AGH-Drone-Engineering/RPi_CM_Drone_Board/images/render2.png

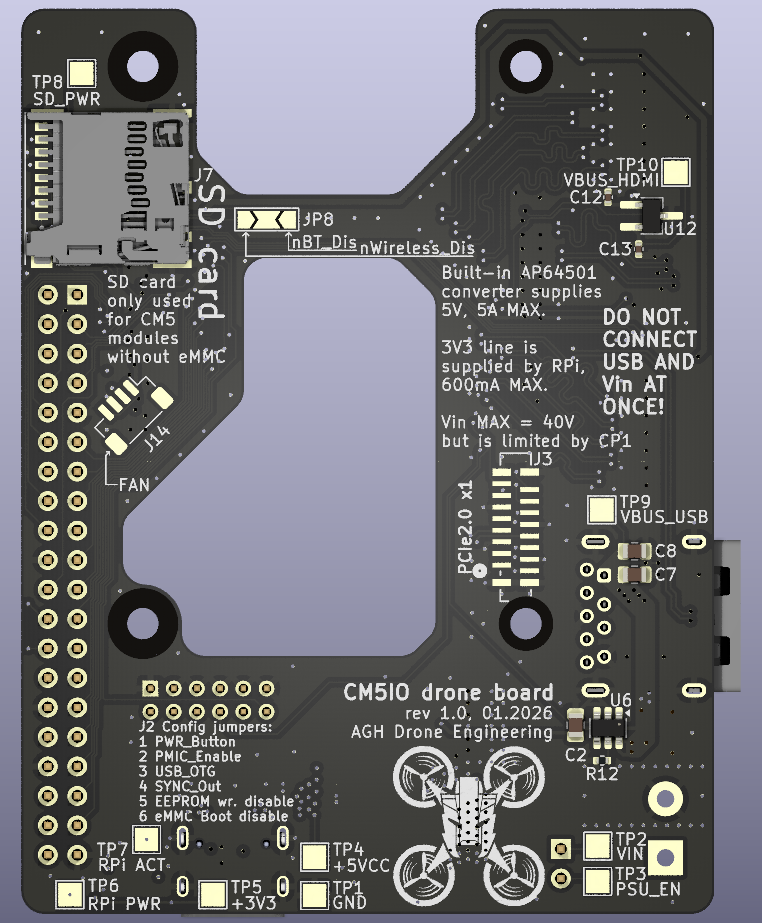
images/render2.png
