AGH-Drone-Engineering/RPi_CM_Drone_Board/images/render4.png

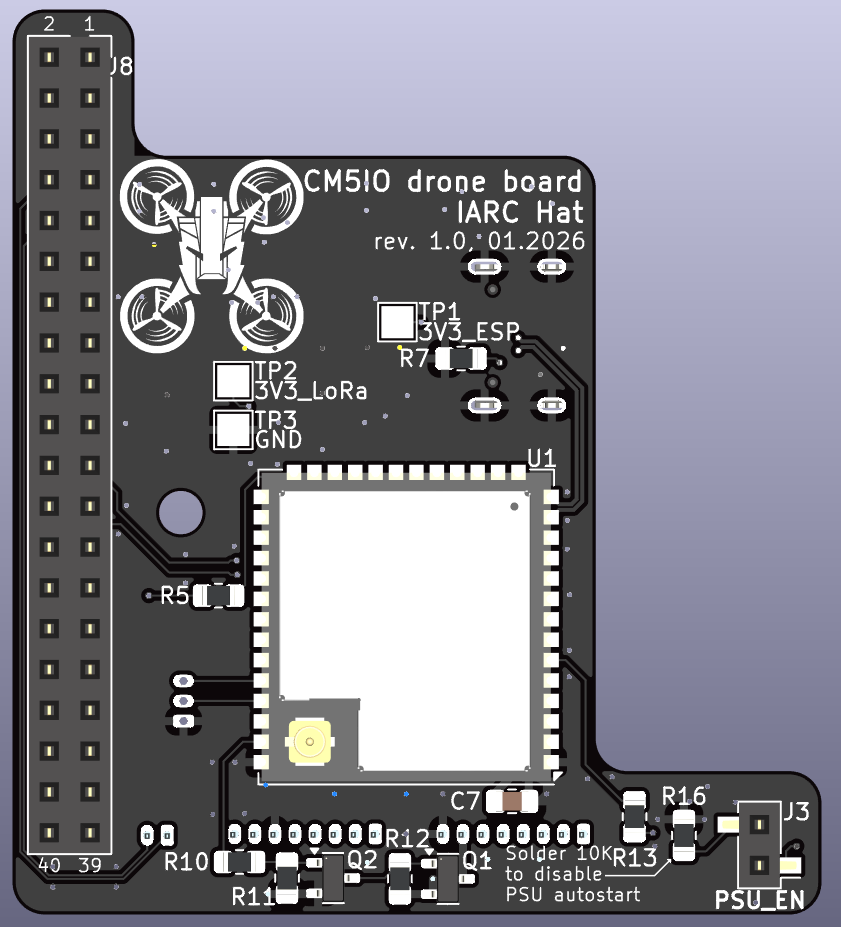
images/render4.png
