AGH-Drone-Engineering/RPi_CM_Drone_Board/images/board1.png

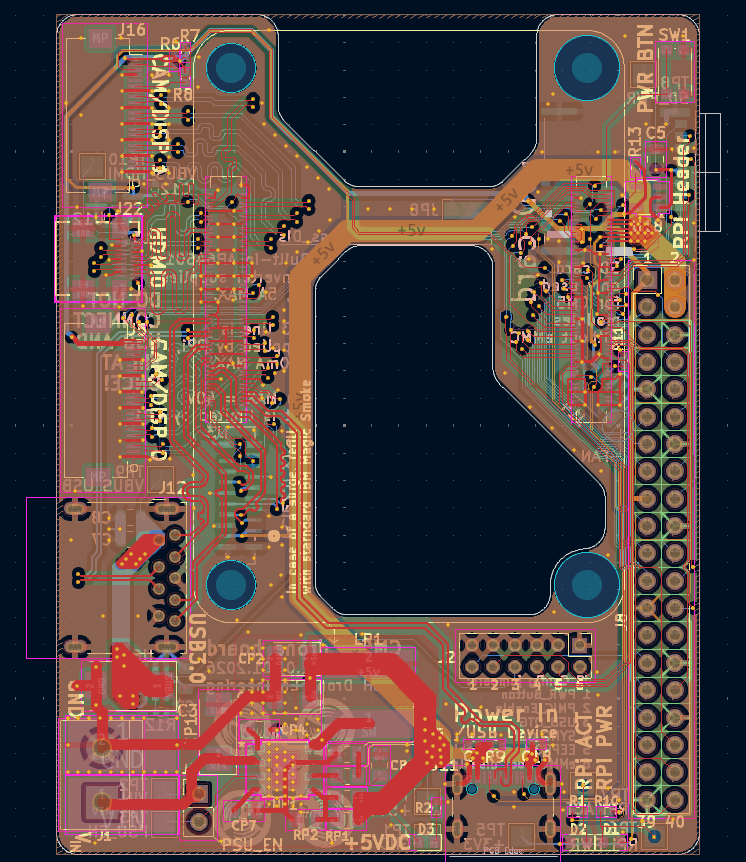
images/board1.png
