AGH-Drone-Engineering/RPi_CM_Drone_Board/images/board2.png

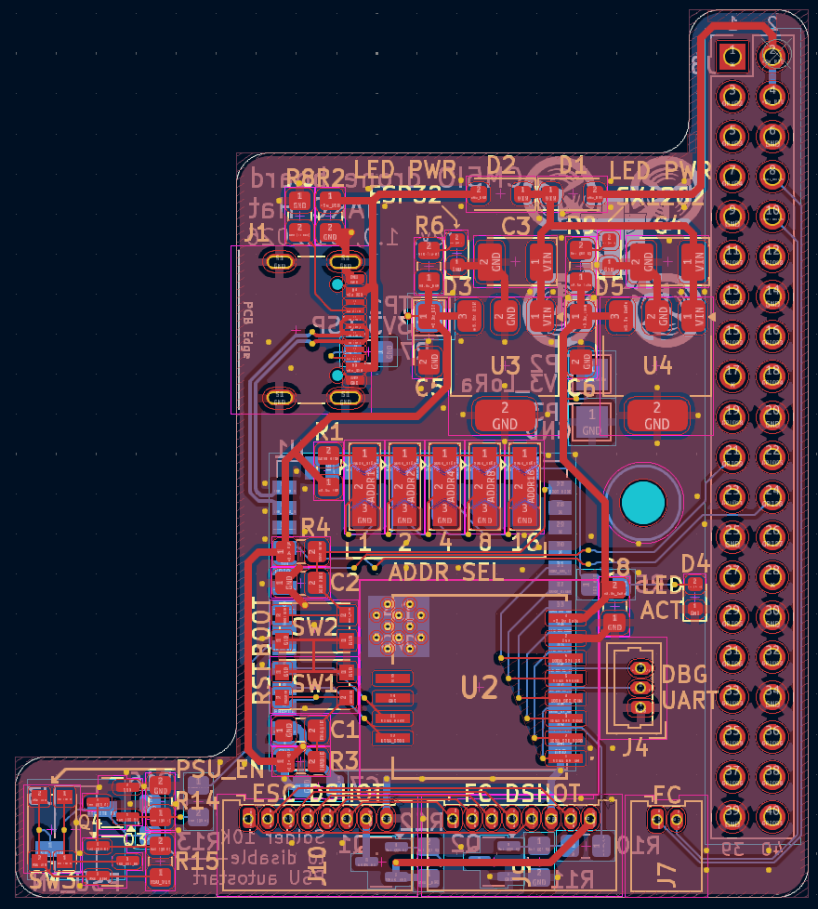
images/board2.png
