AGH-Drone-Engineering/RPi_CM_Drone_Board/images/render1.png

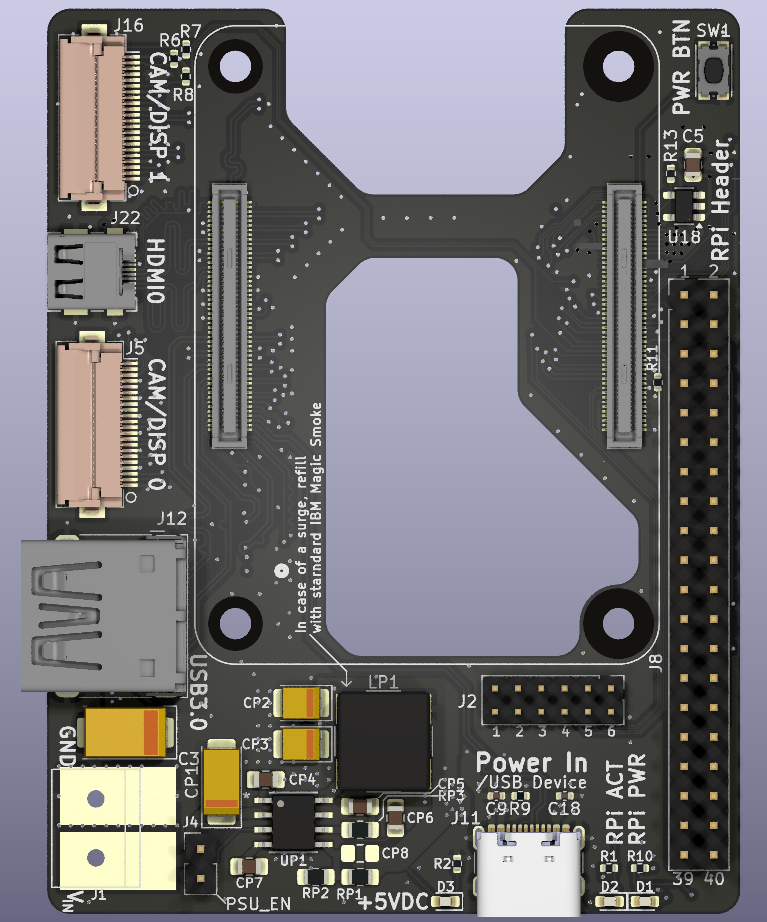
images/render1.png
