AGH-Drone-Engineering/RPi_CM_Drone_Board/images/render3.png

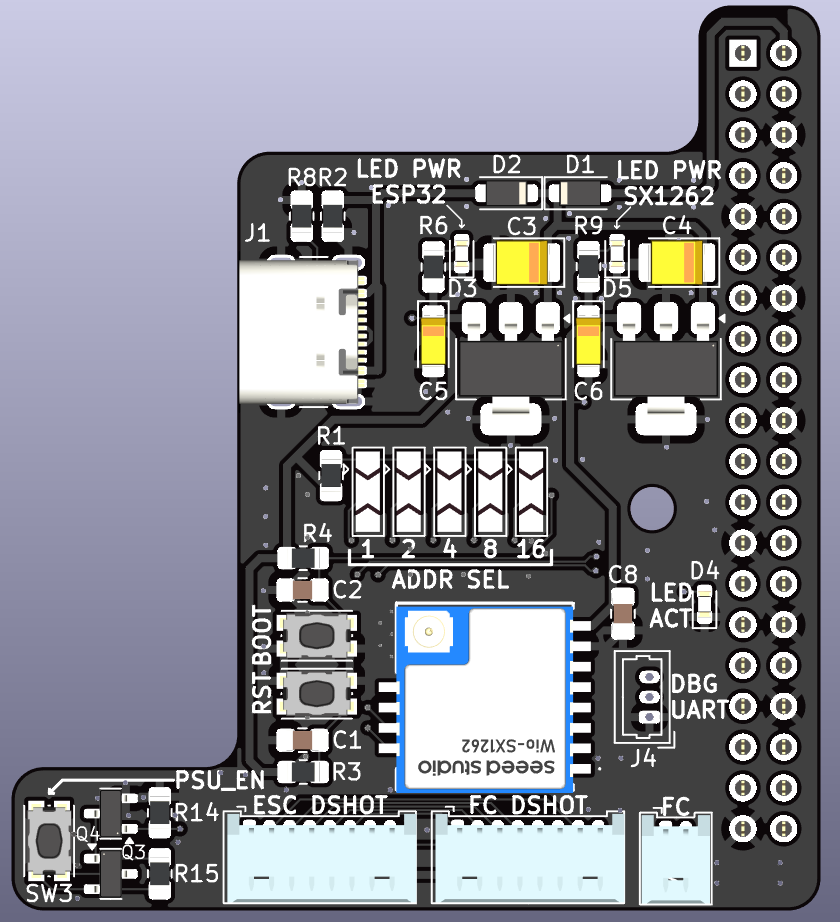
images/render3.png
