AGH-Drone-Engineering/RPi_CM_Drone_Board/pcb_CMDB_rev1/RPI-CM5IO-R2-Gerber050325/Required_impedance_control.xlsx

Signal Layer | Reference Layer | Impedance Type | Trace Width（mil) | Trace Spacing（mil) | Impedance(ohm)±10% | Position
L1 | L2 | Differential Pair (Non coplanar) | 4.25 | 5.9055 | 100
L4 | L3 | Differential Pair (Non coplanar) | 4.25 | 5.9055 | 100
L1 | L2 | Differential Pair (Non coplanar) | 6.6 | 9.9606 | 90
L4 | L3 | Differential Pair (Non coplanar) | 6.6 | 9.9606 | 90
