AGH-Drone-Engineering/RPi_CM_Drone_Board/pcb_CMDB_Adv/CMDB_Adv.kicad_pcb

## KiCad design pcb_CMDB_Adv/CMDB_Adv.kicad_pcb (2026-09-06)

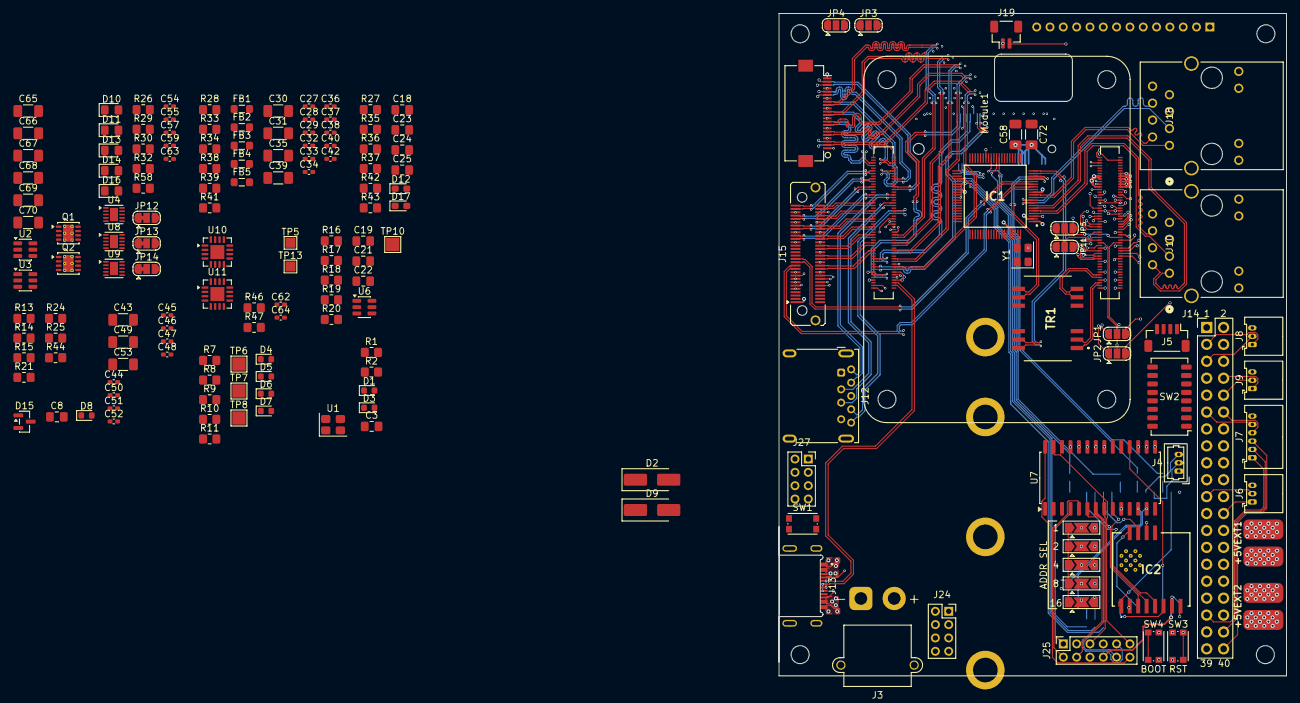
[picture p7: board CMDB_Adv.kicad_pcb from above]

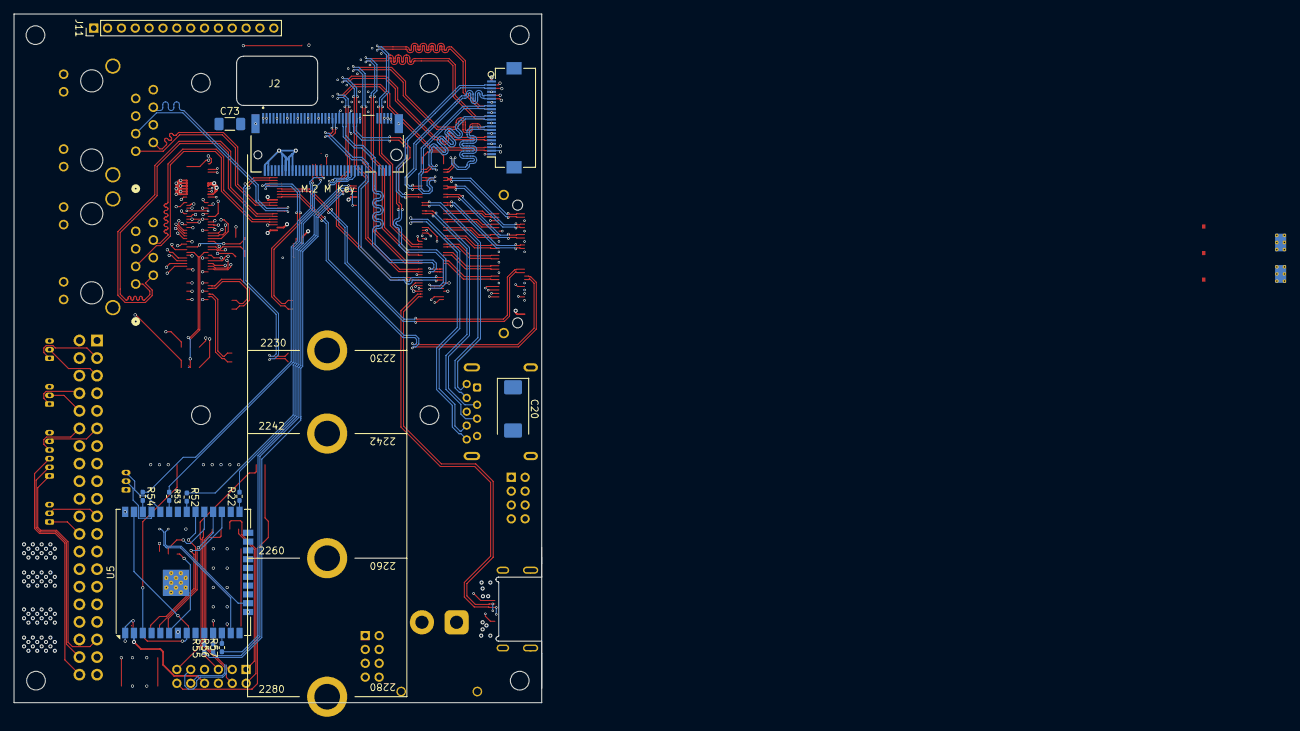
[picture p8: board CMDB_Adv.kicad_pcb from below]

Board: 6 copper layers, 76.2 x 99.4 mm, 190 parts (13 on the bottom side), 277 nets.

Parts:
C3, C18, C23, C24, C25: 100n; C_0805_2012Metric_Pad1.18x1.45mm_HandSolder
C8: 470nF; C_0805_2012Metric_Pad1.18x1.45mm_HandSolder
C19, C21, C22: 10u; C_0805_2012Metric_Pad1.18x1.45mm_HandSolder
C20: 100uF; CP_EIA-7343-31_Kemet-D
C27, C28, C29, C32, C33, C34, C36, C37, C38, C40, C42, C44, C45, C46, C47, C48, C50, C51, C52, C54, C55, C57, C59, C62, C63, C64: 100nF; C_0402_1005Metric_Pad0.74x0.62mm_HandSolder
C30, C31, C35, C39, C43, C49, C58, C72, C73: 22uF; C_1206_3216Metric_Pad1.33x1.80mm_HandSolder
C53, C65, C66, C67, C68, C69, C70: 10uF; C_1206_3216Metric_Pad1.33x1.80mm_HandSolder
D1, D8: LED Green; LED_0603_1608Metric
D2, D9: SS34; D_SMA_Handsoldering
D3: LED Red; LED_0603_1608Metric
D4, D6: GREEN; LED_0603_1608Metric
D5: RED; LED_0603_1608Metric
D7: AMBER; LED_0603_1608Metric
D10: PWR_VALID; D_0805_2012Metric_Pad1.15x1.40mm_HandSolder
D11: +5VPB; D_0805_2012Metric_Pad1.15x1.40mm_HandSolder
D12: ETH4_Y; LED_0603_1608Metric_Pad1.05x0.95mm_HandSolder
D13: +5VEXT1; D_0805_2012Metric_Pad1.15x1.40mm_HandSolder
D14: +5VEXT2; D_0805_2012Metric_Pad1.15x1.40mm_HandSolder
D15: BAT54A; SOT-23
D16: +VIMM; D_0805_2012Metric_Pad1.15x1.40mm_HandSolder
D17: ETH4_G; LED_0603_1608Metric_Pad1.05x0.95mm_HandSolder
FB1, FB2, FB3, FB4, FB5: BLM21PG221SN1D; L_0805_2012Metric_Pad1.05x1.20mm_HandSolder
H1, H2, H3, H4: MountingHole; MountingHole_2.7mm_M2.5_DIN965
IC1: KSZ8795CLXCC; QFP40P1200X1200X160-80N
IC2: Wio-SX1262
J2: Bus_M.2_Socket_M; M.2_M_Key_socket_2280
J3: CONN_VIN; AMASS_XT30PW-M_1x02_P2.50mm_Horizontal
J4: J_ESP_DBG_UART; Molex_PicoBlade_53047-0310_1x03_P1.25mm_Vertical
J5: CONN_FAN; JST_SH_BM04B-SRSS-TB_1x04-1MP_P1.00mm_Vertical
J6: CONN_UART2; Molex_PicoBlade_53048-0310_1x03_P1.25mm_Horizontal
J7: CONN_SPI1; Molex_PicoBlade_53048-0610_1x06_P1.25mm_Horizontal
J8: CONN_I2C1; Molex_PicoBlade_53048-0310_1x03_P1.25mm_Horizontal
J9: CONN_UART0; Molex_PicoBlade_53048-0310_1x03_P1.25mm_Horizontal
J10: ETH1; CONN12_ARJM11B1-009-AB-EW2_ABR
J11: CONN_SDIO; PinHeader_1x14_P2.00mm_Vertical
J12: CONN_USB3_A; USB3_A_Molex_48393-001
J13: CONN_USB_PWR_OTG; GCT_USB4510-03-1-A_REVA
J14: CONN_HAT; PinHeader_2x20_P2.54mm_Vertical
J15: CONN_DOCK; Samtec_LSHM-130-xx.x-x-DV-S_2x30-1SH_P0.50mm_Vertical
J16: CONN_CAM1; Hirose_FH12-22S-0.5SH_1x22-1MP_P0.50mm_Horizontal
J17: CONN_CAM0; Hirose_FH12-22S-0.5SH_1x22-1MP_P0.50mm_Horizontal
J18: ETH2; CONN12_ARJM11B1-009-AB-EW2_ABR
J19: CONN_RTC; JST_SH_BM02B-SRSS-TB_1x02-1MP_P1.00mm_Vertical
J20: CONN_5VEXT1; SolderWirePad_1x01_SMD_3x6mm
J21: CONN_5VEXT1_GND; SolderWirePad_1x01_SMD_3x6mm
J22: CONN_5VEXT2; SolderWirePad_1x01_SMD_3x6mm
J23: CONN_5VEXT2_GND; SolderWirePad_1x01_SMD_3x6mm
J24: AUX_PWR_OUT1; PinSocket_2x04_P2.00mm_Vertical
J25: PL_CTRL_IO; PinSocket_2x06_P2.00mm_Vertical
J27: AUX_PWR_OUT2; PinSocket_2x04_P2.00mm_Vertical
JP1: GPIO0_SEL; SolderJumper-3_P1.3mm_Open_RoundedPad1.0x1.5mm
JP2: GPIO1_SEL; SolderJumper-3_P1.3mm_Open_RoundedPad1.0x1.5mm
JP3: ETH_Y_SEL; SolderJumper-3_P1.3mm_Open_RoundedPad1.0x1.5mm
JP4: ETH_G_SEL; SolderJumper-3_P1.3mm_Open_RoundedPad1.0x1.5mm
JP5: GPIO8_SEL; SolderJumper-3_P1.3mm_Open_RoundedPad1.0x1.5mm
JP6: ADDR1; SolderJumper-3_P2.0mm_Open_TrianglePad1.0x1.5mm
JP7: ADDR2; SolderJumper-3_P2.0mm_Open_TrianglePad1.0x1.5mm
JP8: ADDR4; SolderJumper-3_P2.0mm_Open_TrianglePad1.0x1.5mm
JP9: ADDR8; SolderJumper-3_P2.0mm_Open_TrianglePad1.0x1.5mm
JP10: ADDR16; SolderJumper-3_P2.0mm_Open_TrianglePad1.0x1.5mm
JP11: GPIO9_SEL; SolderJumper-3_P1.3mm_Open_RoundedPad1.0x1.5mm
JP12: +3V3PB2 DIS; SolderJumper-3_P1.3mm_Bridged12_RoundedPad1.0x1.5mm
JP13: +3V3PB3 DIS; SolderJumper-3_P1.3mm_Bridged12_RoundedPad1.0x1.5mm
JP14: +1V2PB DIS; SolderJumper-3_P1.3mm_Bridged12_RoundedPad1.0x1.5mm
Module1: ComputeModule5-CM5; Raspberry-Pi-5-Compute-Module
Q1, Q2: AON7534; DFN-8-1EP_3x3mm_P0.65mm_EP1.6x2.56mm_ThermalVias
R1, R2, R7, R8, R9, R10, R13, R21, R26, R29, R30, R32, R34, R39, R41, R42, R43, R46, R47, R58: 1K; R_0805_2012Metric_Pad1.20x1.40mm_HandSolder
R11, R44: 10K; R_0805_2012Metric_Pad1.20x1.40mm_HandSolder
R14, R15, R38: 4K7; R_0805_2012Metric_Pad1.20x1.40mm_HandSolder
R16, R18, R19, R20: 2.2K; R_0805_2012Metric_Pad1.20x1.40mm_HandSolder
R17: 15K; R_0805_2012Metric_Pad1.20x1.40mm_HandSolder
R22, R52, R53, R54, R55, R56, R57: 22R; R_0402_1005Metric_Pad0.72x0.64mm_HandSolder
R24, R25: 2K2; R_0805_2012Metric_Pad1.20x1.40mm_HandSolder
R27, R35, R36, R37: 220R; R_0805_2012Metric_Pad1.20x1.40mm_HandSolder
R28: 12K4 1%; R_0805_2012Metric_Pad1.20x1.40mm_HandSolder
R33: 330R; R_0805_2012Metric_Pad1.20x1.40mm_HandSolder
SW1: BT_PWR; SW_Push_1P1T_NO_CK_KMR2
SW2: SW_CONFIG; SW_DIP_SPSTx08_Slide_Copal_CHS-08A_W5.08mm_P1.27mm_JPin
SW3: SW_RESET; SW_Push_1P1T_NO_CK_KMR2
SW4: SW_BOOT; SW_Push_1P1T_NO_CK_KMR2
TP5: PWR_VALID0; TestPoint_Pad_1.5x1.5mm
TP6: +3V3 RPi; TestPoint_Pad_2.0x2.0mm
TP7: TP nPWR; TestPoint_Pad_2.0x2.0mm
TP8: TP nACT; TestPoint_Pad_2.0x2.0mm
TP10: TP VBUS_USB; TestPoint_Pad_2.0x2.0mm
TP13: PWR_VALID1; TestPoint_Pad_1.5x1.5mm
TR1: ALANL100X1-DE12DT; ALANL100X1DE12DT
U1: ASEK-32.768KHZ-L-R-T; Crystal_SMD_3225-4Pin_3.2x2.5mm
U2, U3: LM74700; SOT-23-6
U4, U8, U9: TPS7A91; Texas_S-PDSO-N10_EP1.2x2mm
U5: ESP32-WROOM-32UE
U6: AP22653W6; SOT-23-6
U7: MCP23017_SO; SOIC-28W_7.5x17.9mm_P1.27mm
U10, U11: INA3221; Texas_RGV0016A_VQFN-16-1EP_4x4mm_P0.65mm_EP2.1x2.1mm
Y1: ASE-25.000MHZ-LC-T; Oscillator_SMD_Abracon_ASE-4Pin_3.2x2.5mm

Connections:
/+1V2PB: C66.1, FB3.1, FB4.1, U9.1 (OUT), U9.2 (OUT)
/+3V3PB1: C3.1, C58.2, C72.2, C73.2, D1.2 (A), D3.2 (A), J2.2 (3.3V), J2.4 (3.3V), J2.12 (3.3V), J2.14 (3.3V), J2.16 (3.3V), J2.18 (3.3V), J2.70 (3.3V), J2.72 (3.3V), J2.74 (3.3V), U1.1 (EN), U1.4 (VDD)
/+3V3PB2: C49.2, C50.2, C51.2, C52.2, C67.1, D15.1, FB1.1, FB2.1, J25.8, R13.1, R14.1, R15.1, R24.1, R25.1, R44.2, U4.1 (OUT), U4.2 (OUT), U5.2 (VDD), U7.9 (V_{DD})
/+3V3PB3: C43.2, C44.2, C68.1, IC2.8 (VCC), U8.1 (OUT), U8.2 (OUT)
/+5VEXT1: D13.2 (A), J20.1 (Pin_1_1)
/+5VEXT2: D14.2 (A), J22.1 (Pin_1_1)
/+5VPB: C19.1, D11.2 (A), J5.1, J14.2, J14.4, J15.1, Module1.77 (+5v_(Input)), Module1.79 (+5v_(Input)), Module1.81 (+5v_(Input)), Module1.83 (+5v_(Input)), Module1.85 (+5v_(Input)), Module1.87 (+5v_(Input)), Q1.1 (D), Q2.1 (D), U2.4 (CATHODE), U3.4 (CATHODE), U6.1 (IN)
/+VBUS_USBC: C55.2, D2.2 (A), J13.A4_B9 (VBUS), J13.B4_A9 (VBUS), Q2.3 (S), R16.1, U3.3 (EN), U3.6 (ANODE)
/CM5/+3V3RPi: D4.2 (A), D5.2 (A), D6.2 (A), D7.2 (A), J11.1, J14.1, J14.17, J15.3, J16.22, J17.22, Module1.78 (GPIO_VREF(1.8v/3.3v_Input)), Module1.84 (+3.3v_(Output)), Module1.86 (+3.3v_(Output)), R11.1, R18.2, R19.2, R20.1, R27.2, R35.2, R36.2, R37.2, R42.2, R43.2, TP6.1 (1_1)
/CM5/+3V3STB: J19.2, Module1.76 (VBAT)
/CM5/BT_nDis: Module1.91 (BT_nDisable), SW2.11
/CM5/CAM0_GPIO0: J17.17, Module1.97 (CAM_GPIO0)
/CM5/CAM0_GPIO1: J17.18, Module1.100 (CAM_GPIO1)
/CM5/EEPROM_nWP: Module1.20 (EEPROM_nWP), SW2.15
/CM5/ETH.P0_N: Module1.10 (Ethernet_Pair0_N), TR1.6 (RD-)
/CM5/ETH.P0_P: Module1.12 (Ethernet_Pair0_P), TR1.5 (RD+)
/CM5/ETH.P1_N: Module1.6 (Ethernet_Pair1_N), TR1.2 (TD-)
/CM5/ETH.P1_P: Module1.4 (Ethernet_Pair1_P), TR1.1 (TD+)
/CM5/ETH_LED_G: JP4.2 (C), R9.2
/CM5/ETH_LED_Y: JP3.2 (C), R10.2
/CM5/FAN_PWM: J5.2, Module1.19 (FAN_PWM), R11.2
/CM5/GP.0: J14.27, JP1.3 (B)
/CM5/GP.1: J14.28, JP2.3 (B)
/CM5/GP.2: J8.1, J14.3, Module1.58 (GPIO2)
/CM5/GP.3: J8.2, J14.5, Module1.56 (GPIO3)
/CM5/GP.4: J6.1, J14.7, Module1.54 (GPIO4)
/CM5/GP.5: J6.2, J14.29, Module1.34 (GPIO5)
/CM5/GP.6: J14.31, Module1.30 (GPIO6)
/CM5/GP.7: J14.26, Module1.37 (GPIO7)
/CM5/GP.8: J14.24, JP5.3 (B)
/CM5/GP.9: J14.21, JP11.3 (B)
/CM5/GP.10: J14.19, Module1.44 (GPIO10)
/CM5/GP.11: J14.23, Module1.38 (GPIO11)
/CM5/GP.12: J14.32, Module1.31 (GPIO12)
/CM5/GP.13: J14.33, Module1.28 (GPIO13)
/CM5/GP.14: J9.1, J14.8, Module1.55 (GPIO14)
/CM5/GP.15: J9.2, J14.10, Module1.51 (GPIO15)
/CM5/GP.16: J14.36, Module1.29 (GPIO16)
/CM5/GP.17: J7.5, J14.11, Module1.50 (GPIO17)
/CM5/GP.18: J7.4, J14.12, Module1.49 (GPIO18)
/CM5/GP.19: J7.1, J14.35, Module1.26 (GPIO19)
/CM5/GP.20: J7.2, J14.38, Module1.27 (GPIO20)
/CM5/GP.21: J7.3, J14.40, Module1.25 (GPIO21)
/CM5/GP.22: J14.15, Module1.46 (GPIO22)
/CM5/GP.23: J14.16, Module1.47 (GPIO23)
/CM5/GP.24: J14.18, Module1.45 (GPIO24)
/CM5/GP.25: J14.22, Module1.41 (GPIO25)
/CM5/GP.26: J14.37, Module1.24 (GPIO26)
/CM5/GP.27: J14.13, Module1.48 (GPIO27)
/CM5/GPIO0_RAW: JP1.2 (C), Module1.36 (ID_SD)
/CM5/GPIO1_RAW: JP2.2 (C), Module1.35 (ID_SC)
/CM5/GPIO8_RAW: JP5.2 (C), Module1.39 (GPIO8)
/CM5/GPIO9_RAW: JP11.2 (C), Module1.40 (GPIO9)
/CM5/HDMI0.CEC: J15.15, Module1.151 (HDMI0_CEC)
/CM5/HDMI0.CK_N: J15.59, Module1.190 (HDMI0_CLK_N)
/CM5/HDMI0.CK_P: J15.57, Module1.188 (HDMI0_CLK_P)
/CM5/HDMI0.D0_N: J15.53, Module1.184 (HDMI0_TX0_N)
/CM5/HDMI0.D0_P: J15.51, Module1.182 (HDMI0_TX0_P)
/CM5/HDMI0.D1_N: J15.47, Module1.178 (HDMI0_TX1_N)
/CM5/HDMI0.D1_P: J15.45, Module1.176 (HDMI0_TX1_P)
/CM5/HDMI0.D2_N: J15.41, Module1.172 (HDMI0_TX2_N)
/CM5/HDMI0.D2_P: J15.39, Module1.170 (HDMI0_TX2_P)
/CM5/HDMI0.HP: J15.17, Module1.153 (HDMI0_HOTPLUG)
/CM5/HDMI0.SCL: J15.11, Module1.200 (HDMI0_SCL)
/CM5/HDMI0.SDA: J15.13, Module1.199 (HDMI0_SDA)
/CM5/HDMI1.CEC: J15.16, Module1.149 (HDMI1_CEC)
/CM5/HDMI1.CK_N: J15.60, Module1.166 (HDMI1_CLK_N)
/CM5/HDMI1.CK_P: J15.58, Module1.164 (HDMI1_CLK_P)
/CM5/HDMI1.D0_N: J15.54, Module1.160 (HDMI1_TX0_N)
/CM5/HDMI1.D0_P: J15.52, Module1.158 (HDMI1_TX0_P)
/CM5/HDMI1.D1_N: J15.48, Module1.154 (HDMI1_TX1_N)
/CM5/HDMI1.D1_P: J15.46, Module1.152 (HDMI1_TX1_P)
/CM5/HDMI1.D2_N: J15.42, Module1.148 (HDMI1_TX2_N)
/CM5/HDMI1.D2_P: J15.40, Module1.146 (HDMI1_TX2_P)
/CM5/HDMI1.HP: J15.18, Module1.143 (HDMI1_HOTPLUG)
/CM5/HDMI1.SCL: J15.12, Module1.147 (HDMI1_SCL)
/CM5/HDMI1.SDA: J15.14, Module1.145 (HDMI1_SDA)
/CM5/MIPI0.CK_N: J17.8, Module1.127 (MIPI0_C_N)
/CM5/MIPI0.CK_P: J17.9, Module1.129 (MIPI0_C_P)
/CM5/MIPI0.D0_N: J17.2, Module1.115 (MIPI0_D0_N)
/CM5/MIPI0.D0_P: J17.3, Module1.117 (MIPI0_D0_P)
/CM5/MIPI0.D1_N: J17.5, Module1.121 (MIPI0_D1_N)
/CM5/MIPI0.D1_P: J17.6, Module1.123 (MIPI0_D1_P)
/CM5/MIPI0.D2_N: J17.11, Module1.133 (MIPI0_D2_N)
/CM5/MIPI0.D2_P: J17.12, Module1.135 (MIPI0_D2_P)
/CM5/MIPI0.D3_N: J17.14, Module1.139 (MIPI0_D3_N)
/CM5/MIPI0.D3_P: J17.15, Module1.141 (MIPI0_D3_P)
/CM5/MIPI0_ID_SCL: J17.20, Module1.80 (SCL0)
/CM5/MIPI0_ID_SDA: J17.21, Module1.82 (SDA0)
/CM5/MIPI1.CK_N: J16.8, Module1.187 (MIPI1_C_N)
/CM5/MIPI1.CK_P: J16.9, Module1.189 (MIPI1_C_P)
/CM5/MIPI1.D0_N: J16.2, Module1.175 (MIPI1_D0_N)
/CM5/MIPI1.D0_P: J16.3, Module1.177 (MIPI1_D0_P)
/CM5/MIPI1.D1_N: J16.5, Module1.181 (MIPI1_D1_N)
/CM5/MIPI1.D1_P: J16.6, Module1.183 (MIPI1_D1_P)
/CM5/MIPI1.D2_N: J16.11, Module1.193 (MIPI1_D2_N)
/CM5/MIPI1.D2_P: J16.12, Module1.195 (MIPI1_D2_P)
/CM5/MIPI1.D3_N: J16.14, Module1.194 (MIPI1_D3_N)
/CM5/MIPI1.D3_P: J16.15, Module1.196 (MIPI1_D3_P)
/CM5/MIPI1_ID_SCL: J16.20, JP2.1 (A), R19.1
/CM5/MIPI1_ID_SDA: J16.21, JP1.1 (A), R18.1
/CM5/PCIe.CLK_N: J2.53 (REFCLKn), Module1.112 (PCIe_CLK_N)
/CM5/PCIe.CLK_P: J2.55 (REFCLKp), Module1.110 (PCIe_CLK_P)
/CM5/PCIe.RX_N: J2.41 (PETn0), Module1.118 (PCIe_RX_N)
/CM5/PCIe.RX_P: J2.43 (PETp0), Module1.116 (PCIe_RX_P)
/CM5/PCIe.TX_N: J2.47 (PERn0), Module1.124 (PCIe_TX_N)
/CM5/PCIe.TX_P: J2.49 (PERp0), Module1.122 (PCIe_TX_P)
/CM5/PCIe.nCLKREQ: J2.52 (~CLKREQ), Module1.102 (PCIe_nCLKREQ)
/CM5/PCIe.nRST: J2.50 (~PERST), Module1.109 (PCIe_nRST)
/CM5/PCIe.nWAKE: J2.54 (~PEWAKE), Module1.104 (PCIE_nWAKE)
/CM5/PMIC_ENABLE: Module1.99 (PMIC_ENABLE), SW2.13
/CM5/PWR_BUT: Module1.92 (PWR_BUT), SW1.2
/CM5/RPI_ETH_G: JP4.1 (A), Module1.15 (Ethernet_nLED3(3.3v))
/CM5/RPI_ETH_Y: JP3.1 (A), Module1.17 (Ethernet_nLED2(3.3v))
/CM5/SD.CLK: J11.12, Module1.57 (SD_CLK)
/CM5/SD.CMD: J11.13, Module1.62 (SD_CMD)
/CM5/SD.DAT0: J11.3, Module1.63 (SD_DAT0)
/CM5/SD.DAT1: J11.4, Module1.67 (SD_DAT1)
/CM5/SD.DAT2: J11.5, Module1.69 (SD_DAT2)
/CM5/SD.DAT3: J11.6, Module1.61 (SD_DAT3)
/CM5/SD.DAT4: J11.8, Module1.68 (SD_DAT4)
/CM5/SD.DAT5: J11.9, Module1.64 (SD_DAT5)
/CM5/SD.DAT6: J11.10, Module1.72 (SD_DAT6)
/CM5/SD.DAT7: J11.11, Module1.70 (SD_DAT7)
/CM5/SD.PWR_EN: J11.2, Module1.75 (SD_PWR_ON)
/CM5/TACHO: J5.4, Module1.16 (FAN_TACHO)
/CM5/UART_PCTL_RX: JP11.1 (A), U5.23 (IO15)
/CM5/UART_PCTL_TX: JP5.1 (A), U5.4 (SENSOR_VP)
/CM5/USB0.D_N: J15.30, Module1.136 (USB3-0-D_N)
/CM5/USB0.D_P: J15.28, Module1.134 (USB3-0-D_P)
/CM5/USB0.RX_N: J15.22, Module1.128 (USB3-0-RX_N)
/CM5/USB0.RX_P: J15.24, Module1.130 (USB3-0-RX_P)
/CM5/USB0.TX_N: J15.34, Module1.140 (USB3-0-TX_N)
/CM5/USB0.TX_P: J15.36, Module1.142 (USB3-0-TX_P)
/CM5/USB1.D_N: J12.2 (D-), Module1.165 (USB3-1-D_N)
/CM5/USB1.D_P: J12.3 (D+), Module1.163 (USB3-1-D_P)
/CM5/USB1.RX_N: J12.5 (SSRX-), Module1.157 (USB3-1-RX_N)
/CM5/USB1.RX_P: J12.6 (SSRX+), Module1.159 (USB3-1-RX_P)
/CM5/USB1.TX_N: J12.8 (SSTX-), Module1.169 (USB3-1-TX_N)
/CM5/USB1.TX_P: J12.9 (SSTX+), Module1.171 (USB3-1-TX_P)
/CM5/USBC.CC1: J13.A5 (CC1), Module1.94 (CC1)
/CM5/USBC.CC2: J13.B5 (CC2), Module1.96 (CC2)
/CM5/USBC.D_N: J13.A7 (D-), J13.B7 (D-), Module1.103 (USB2_N)
/CM5/USBC.D_P: J13.A6 (D+), J13.B6 (D+), Module1.105 (USB2_P)
/CM5/USBOTG: Module1.101 (USB_OTG_ID), SW2.14
/CM5/VBUS_USBA_EN: Module1.111 (VBUS_EN), U6.3 (EN)
/CM5/WL_nDis: Module1.89 (WiFi_nDisable), SW2.12
/CM5/nACT_LED: Module1.21 (LED_nACT), R7.2, TP8.1 (1_1)
/CM5/nPWR_LED: Module1.95 (LED_nPWR), R8.2, TP7.1 (1_1)
/CM5/nRPIBOOT: Module1.93 (nRPIBOOT), SW2.16
/ETH3.LED_G: D17.1 (K), R41.1
/ETH3.LED_Y: D12.1 (K), R34.2, R39.1
/ETH3.RX_N: IC1.14 (RXM3), J15.23
/ETH3.RX_P: IC1.13 (RXP3), J15.21
/ETH3.TX_N: IC1.16 (TXM3), J15.27
/ETH3.TX_P: IC1.15 (TXP3), J15.25
/Eth Switch/+VDD12A: C39.2, C40.2, FB4.2, IC1.1 (VDD12A)
/Eth Switch/+VDD12D: C35.2, C36.2, C37.2, C38.2, FB3.2, IC1.26 (VDD12D_1), IC1.42 (VDD12D_2), IC1.73 (VDD12D_3)
/Eth Switch/+VDDAT: C27.2, C28.2, C29.2, C30.2, FB1.2, FB5.1, IC1.2 (VDDAT33_1), IC1.12 (VDDAT33_2), IC1.76 (VDDAT33_3)
/Eth Switch/+VDDIO: C31.2, C32.2, C33.2, C34.2, FB2.2, IC1.34 (VDDIO_1), IC1.48 (VDDIO_2), IC1.70 (VDDIO_3), R38.1
/Eth Switch/+VDDOSC: C42.2, FB5.2, Y1.1 (EN), Y1.4 (Vdd)
/Eth Switch/ETH1.LED_G: IC1.65 (LED1_0), J10.10
/Eth Switch/ETH1.LED_Y: IC1.64 (LED1_1), J10.11
/Eth Switch/ETH1.RX_N: IC1.5 (RXM1), J10.6 (RD-)
/Eth Switch/ETH1.RX_P: IC1.4 (RXP1), J10.3 (RD+)
/Eth Switch/ETH1.TX_N: IC1.7 (TXM1), J10.2 (TD-)
/Eth Switch/ETH1.TX_P: IC1.6 (TXP1), J10.1 (TD+)
/Eth Switch/ETH2.LED_G: IC1.63 (LED2_0), J18.10
/Eth Switch/ETH2.LED_Y: IC1.62 (LED2_1), J18.11
/Eth Switch/ETH2.RX_N: IC1.9 (RXM2), J18.6 (RD-)
/Eth Switch/ETH2.RX_P: IC1.8 (RXP2), J18.3 (RD+)
/Eth Switch/ETH2.TX_N: IC1.11 (TXM2), J18.2 (TD-)
/Eth Switch/ETH2.TX_P: IC1.10 (TXP2), J18.1 (TD+)
/Eth Switch/ETH4.RX_N: IC1.18 (RXM4), TR1.7 (RX-)
/Eth Switch/ETH4.RX_P: IC1.17 (RXP4), TR1.8 (RX+)
/Eth Switch/ETH4.TX_N: IC1.20 (TXM4), TR1.11 (TX-)
/Eth Switch/ETH4.TX_P: IC1.19 (TXP4), TR1.12 (TX+)
/Eth Switch/MGMT_SPI.CS: IC1.69 (SPIS_N), U5.9 (IO33)
/Eth Switch/MGMT_SPI.MISO: IC1.66 (SPIQ), IC2.2 (MISO), R33.2, U5.7 (IO35)
/Eth Switch/MGMT_SPI.MOSI: IC1.68 (SDA_MDIO), IC2.3 (MOSI), U5.28 (IO17)
/Eth Switch/MGMT_SPI.SCLK: IC1.67 (SCL_MDC), IC2.4 (SCK), U5.30 (IO18)
/Eth Switch/RMII.CRS_DV: IC1.51 (RXDV5/CRSDV5/RXD5_CTL), R57.1
/Eth Switch/RMII.REFCLK: IC1.44 (RXC5/GRXC5), R22.2
/Eth Switch/RMII.RXD0: IC1.45 (RXD5_0), R55.1
/Eth Switch/RMII.RXD1: IC1.46 (RXD5_1), R56.1
/Eth Switch/RMII.TXD0: IC1.30 (TXD5_0), R52.1
/Eth Switch/RMII.TXD1: IC1.32 (TXD5_1), R54.1
/Eth Switch/RMII.TX_EN: IC1.29 (TXEN5/TXDS5_CTL), R53.1
/Eth Switch/RST_N: C53.1, D15.3, IC1.72 (RST_N), R44.1, U5.26 (IO4)
/Eth Switch/SWITCH_INT: IC1.23 (INTR_N), R38.2, U5.5 (SENSOR_VN)
/IO Connectors/+VBUS_USBA: C20.1, C21.1, C22.1, J12.1 (VBUS), J15.2, J15.4, TP10.1 (1_1), U6.6 (OUT)
/IO Connectors/CAM1_GPIO0: J16.17, R20.2
/IO Connectors/PCTL_DBG_UART_RX: J4.3, J15.7, U5.34 (RXD0/IO3)
/IO Connectors/PCTL_DBG_UART_TX: J4.2, J15.5, U5.35 (TXD0/IO1)
/PSU/+VIMM: C65.1, C69.1, C70.1, D2.1 (K), D9.1 (K), D16.2 (A), JP12.1 (A), JP13.1 (A), JP14.1 (A), U4.9 (IN), U4.10 (IN), U8.9 (IN), U8.10 (IN), U9.9 (IN), U9.10 (IN)
/PSU/+VIN: J3.2, J24.4, J24.5, J24.6, J24.7, J24.8
/PSU/PSU Converters/+5VPB: C54.2, J27.5, J27.6, Q1.3 (S), U2.3 (EN), U2.6 (ANODE)
/PSU/PSU Converters/+I2C_SCL: U10.6 (SCL), U11.6 (SCL)
/PSU/PSU Converters/+I2C_SDA: U10.7 (SDA), U11.7 (SDA)
/PSU/PSU Converters/+VIMM: C62.2, C64.2, D9.2 (A), J27.7, J27.8, U10.4 (VS), U11.4 (VS), U11.5 (A0)
/PSU/PSU Converters/POWER_VALID0: R46.2, TP5.1 (1_1), U10.10 (PV)
/PSU/PSU Converters/POWER_VALID1: R47.2, TP13.1 (1_1), U11.10 (PV)
/Platform Controller/ADDR1: JP6.2 (C), U7.21 (GPA0)
/Platform Controller/ADDR2: JP7.2 (C), U7.22 (GPA1)
/Platform Controller/ADDR4: JP8.2 (C), U7.23 (GPA2)
/Platform Controller/ADDR8: JP9.2 (C), U7.24 (GPA3)
/Platform Controller/ADDR16: JP10.2 (C), U7.25 (GPA4)
/Platform Controller/ADDR_HIGH: JP6.1 (A), JP7.1 (A), JP8.1 (A), JP9.1 (A), JP10.1 (A), R13.2
/Platform Controller/BOOT_MODE: R15.2, R22.1, SW4.2, U5.25 (IO0)
/Platform Controller/ENABLE: C8.2, D15.2, R14.2, SW3.2, U5.3 (EN), U7.18 (~RESET)
/Platform Controller/I2C_SCL: J25.9, R25.2, U5.16 (IO13), U7.12 (SCK)
/Platform Controller/I2C_SDA: J25.10, R24.2, U5.13 (IO14), U7.13 (SDA)
/Platform Controller/LED_ACT: R21.1, U7.26 (GPA5)
/Platform Controller/LORA_BUSY: IC2.11 (BUSY), U5.29 (IO5)
/Platform Controller/LORA_CS: IC2.6 (NSS), U5.8 (IO32)
/Platform Controller/LORA_DIO1: IC2.12 (DIO1), U5.6 (IO34)
/Platform Controller/LORA_RESET: IC2.5 (NRST), U5.27 (IO16)
/Platform Controller/LORA_RF_SW: IC2.1 (RF_SW_), U5.37 (IO23)
GND: C3.2, C8.1, C18.2, C19.2, C20.2, C21.2, C22.2, C23.2, C24.2, C25.2, C27.1, C28.1, C29.1, C30.1, C31.1, C32.1, C33.1, C34.1, C35.1, C36.1, C37.1, C38.1, C39.1, C40.1, C42.1, C43.1, C44.1, C45.2, C46.2, C47.2, C48.2, C49.1, C50.1, C51.1, C52.1, C53.2, C57.1, C58.1, C59.1, C62.1, C63.1, C64.1, C65.2, C66.2, C67.2, C68.2, C69.2, C70.2, C72.1, C73.1, D8.1 (K), IC1.3 (GNDA_1), IC1.21 (GNDA_2), IC1.27 (GNDD_1), IC1.33 (GNDD_2), IC1.47 (GNDD_3), IC1.61 (GNDD_4), IC1.71 (GNDD_5), IC1.78 (GNDA_3), IC2.7 (GND_1), IC2.10 (GND_2), J2.1 (GND), J2.3 (GND), J2.9 (GND), J2.15 (GND), J2.21 (GND), J2.27 (GND), J2.33 (GND), J2.39 (GND), J2.45 (GND), J2.51 (GND), J2.57 (GND), J2.71 (GND), J2.73 (GND), J2.75 (GND), J2.M1 (GND2230), J2.M2 (GND2242), J2.M3 (GND2260), J2.M4 (GND2280), J2.S1, J2.S2, J3.1, J4.1, J5.3, J6.3, J7.6, J8.3, J9.3, J10.8, J11.7, J11.14, J12.4 (GND), J12.7 (DRAIN), J12.10 (SHIELD), J13.A1_B12 (GND), J13.B1_A12 (GND), J13.S1 (SHIELD), J13.S2 (SHIELD), J13.S3 (SHIELD), J13.S4 (SHIELD), J14.6, J14.9, J14.14, J14.20, J14.25, J14.30, J14.34, J14.39, J15.9, J15.10, J15.19, J15.20, J15.26, J15.32, J15.37, J15.38, J15.43, J15.44, J15.49, J15.50, J15.55, J15.56, J15.SH (Shield), J16.1, J16.4, J16.7, J16.10, J16.13, J16.16, J16.19, J17.1, J17.4, J17.7, J17.10, J17.13, J17.16, J17.19, J18.8, J19.1, J21.1 (Pin_1_1), J23.1 (Pin_1_1), J24.1, J24.2, J24.3, J25.6, J25.7, J27.1, J27.2, J27.3, J27.4, JP6.3 (B), JP7.3 (B), JP8.3 (B), JP9.3 (B), JP10.3 (B), JP12.3 (B), JP13.3 (B), JP14.3 (B), Module1.1 (GND), Module1.2 (GND), Module1.7 (GND), Module1.8 (GND), Module1.13 (GND), Module1.14 (GND), Module1.22 (GND), Module1.23 (GND), Module1.32 (GND), Module1.33 (GND), Module1.42 (GND), Module1.43 (GND), Module1.52 (GND), Module1.53 (GND), Module1.59 (GND), Module1.60 (GND), Module1.65 (GND), Module1.66 (GND), Module1.71 (GND), Module1.74 (GND), Module1.98 (GND), Module1.107 (GND), Module1.108 (GND), Module1.113 (GND), Module1.114 (GND), Module1.119 (GND), Module1.120 (GND), Module1.125 (GND), Module1.126 (GND), Module1.131 (GND), Module1.132 (GND), Module1.137 (GND), Module1.138 (GND), Module1.144 (GND), Module1.150 (GND), Module1.155 (GND), Module1.156 (GND), Module1.161 (GND), Module1.162 (GND), Module1.167 (GND), Module1.168 (GND), Module1.173 (GND), Module1.174 (GND), Module1.179 (GND), Module1.180 (GND), Module1.185 (GND), Module1.186 (GND), Module1.191 (GND), Module1.192 (GND), Module1.197 (GND), Module1.198 (GND), R2.2, R16.2, R17.2, R26.2, R28.1, R29.2, R30.2, R32.2, R33.1, R34.1, R58.2, SW1.1, SW2.1, SW2.2, SW2.3, SW2.4, SW2.5, SW2.6, SW2.7, SW2.8, SW3.1, SW4.1, U1.2 (GND), U2.2 (GND), U3.2 (GND), U4.4 (GND), U4.6 (SS_CTRL), U4.11 (GND), U5.1 (GND), U5.15 (GND), U5.38 (GND), U5.39 (GND), U6.2 (GND), U7.10 (V_{SS}), U7.15 (A0), U7.16 (A1), U7.17 (A2), U8.4 (GND), U8.6 (SS_CTRL), U8.11 (GND), U9.4 (GND), U9.6 (SS_CTRL), U9.11 (GND), U10.3 (GND), U10.5 (A0), U10.17 (EP), U11.3 (GND), U11.17 (EP), Y1.2 (GND)
unnamed: D1.1 (K), R1.1
unnamed: D3.1 (K), R2.1
unnamed: D4.1 (K), R7.1
unnamed: D5.1 (K), R8.1
unnamed: D6.1 (K), R9.1
unnamed: D7.1 (K), R10.1
unnamed: D8.2 (A), R21.2
unnamed: D10.1 (K), R26.1
unnamed: D11.1 (K), R58.1
unnamed: D12.2 (A), R43.1
unnamed: D13.1 (K), R29.1
unnamed: D14.1 (K), R30.1
unnamed: D16.1 (K), R32.1
unnamed: D17.2 (A), R42.1
unnamed: IC1.77 (ISET), R28.2
unnamed: IC1.25 (LED3_0), R41.2
unnamed: IC1.24 (LED3_1), R39.2
unnamed: IC1.79 (XI), Y1.3 (OUT)
unnamed: J2.10 (DAS/~DSS/~LED1), R1.2
unnamed: J2.68 (SUSCLK), U1.3 (Out)
unnamed: J10.9, R35.1
unnamed: J10.12, R27.1
unnamed: C25.1, J10.5 (RCT)
unnamed: C18.1, J10.4 (TCT)
unnamed: J18.9, R37.1
unnamed: J18.12, R36.1
unnamed: C23.1, J18.5 (RCT)
unnamed: C24.1, J18.4 (TCT)
unnamed: J25.1, U7.4 (GPB3)
unnamed: J25.2, U7.5 (GPB4)
unnamed: J25.3, U7.6 (GPB5)
unnamed: J25.4, U7.7 (GPB6)
unnamed: J25.5, U7.8 (GPB7)
unnamed: J25.11, U7.27 (GPA6)
unnamed: J25.12, U7.28 (GPA7)
unnamed: JP12.2 (C), U4.7 (EN)
unnamed: JP13.2 (C), U8.7 (EN)
unnamed: JP14.2 (C), U9.7 (EN)
unnamed: Q1.2 (G), U2.5 (GATE)
unnamed: Q2.2 (G), U3.5 (GATE)
unnamed: C46.1, TR1.4 (C_RD)
unnamed: C48.1, TR1.9 (C_RX)
unnamed: C45.1, TR1.3 (C_TD)
unnamed: C47.1, TR1.10 (C_TX)
unnamed: C54.1, U2.1 (VCAP)
unnamed: C55.1, U3.1 (VCAP)
unnamed: C57.2, U4.8 (NR/SS)
unnamed: R52.2, U5.31 (IO19)
unnamed: R53.2, U5.33 (IO21)
unnamed: R54.2, U5.36 (IO22)
unnamed: R55.2, U5.10 (IO25)
unnamed: R56.2, U5.11 (IO26)
unnamed: R57.2, U5.12 (IO27)
unnamed: R17.1, U6.5 (ILIM)
unnamed: C59.2, U8.8 (NR/SS)
unnamed: C63.2, U9.8 (NR/SS)
unnamed: R46.1, U10.16 (VPU)
unnamed: R47.1, U11.16 (VPU)
