AGH-Drone-Engineering/RPi_CM_Drone_Board/pcb_CMDB_rev1/CM5IO.kicad_pcb

## KiCad design pcb_CMDB_rev1/CM5IO.kicad_pcb (2026-07-15)

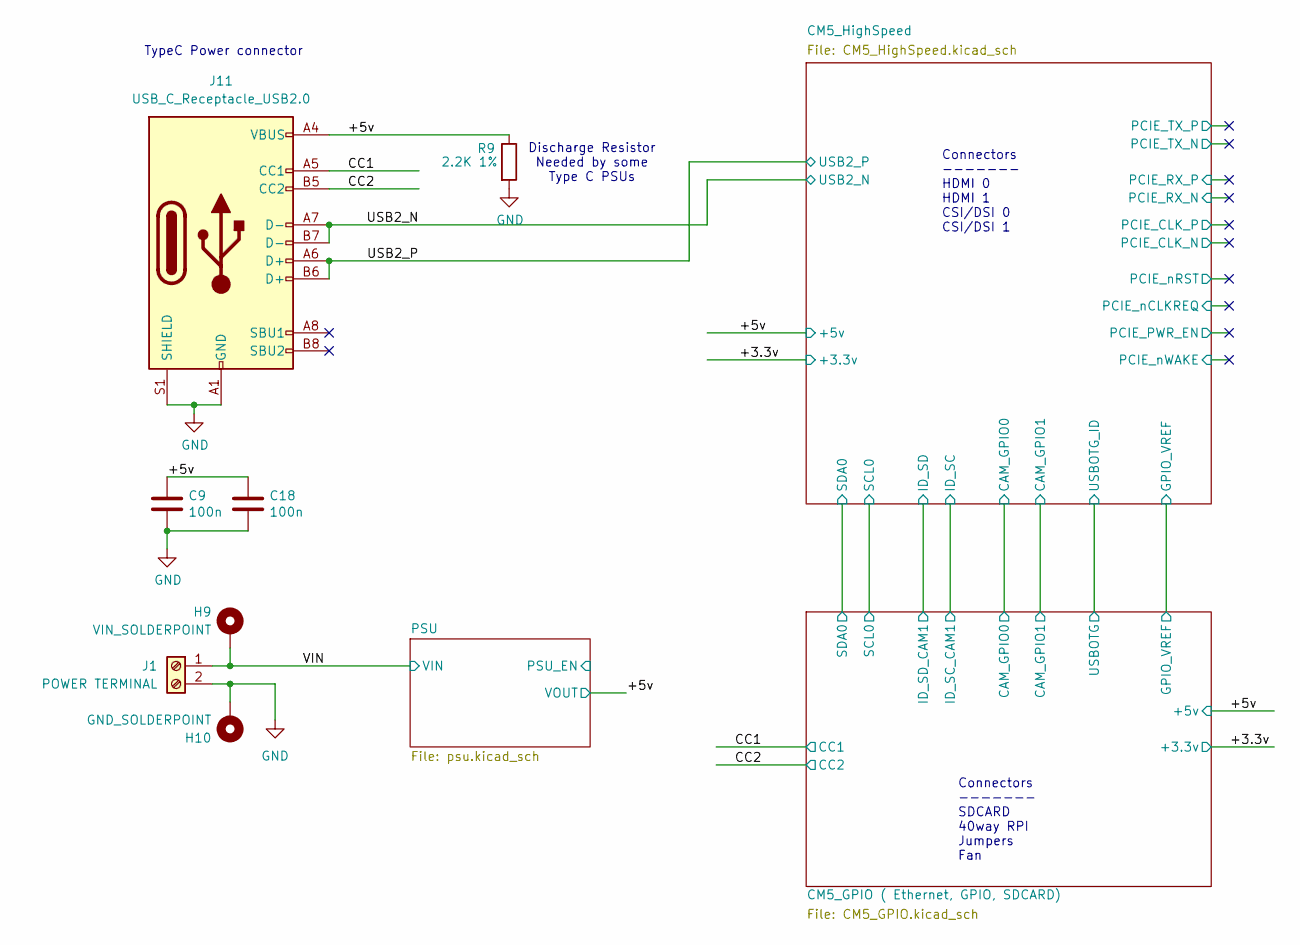
[picture p9: schematic CM5IO.kicad_sch, Compute Module Drone Board]

Parts:
C9, C18: 100n; C_0402_1005Metric; Part Description 0.1uF 10% 16V Ceramic Capacitor X7R 040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
H9: VIN_SOLDERPOINT; SolderWirePad_1x01_SMD_5x10mm
H10: GND_SOLDERPOINT; SolderWirePad_1x01_SMD_5x10mm
J1: POWER TERMINAL; TerminalBlock_bornier-2_P5.08mm
J11: USB_C_Receptacle_USB2.0; USB_C_Receptacle_GCT_USB4105-xx-A_16P_TopMnt_Horizontal; Part Description USBC USB2 data and power connector
R9: 2.2K 1%; R_0402_1005Metric; Part Description Resistor 2.2K M1005 1% 63mW

Connections:
/+5v: C9.1, C18.1, J11.A4 (VBUS), J11.A9 (VBUS), J11.B4 (VBUS), J11.B9 (VBUS), R9.1; also elsewhere on the board
/CC1: J11.A5 (CC1); also elsewhere on the board
/CC2: J11.B5 (CC2); also elsewhere on the board
/USB2_N: J11.A7 (D-), J11.B7 (D-); also elsewhere on the board
/USB2_P: J11.A6 (D+), J11.B6 (D+); also elsewhere on the board
/VIN: H9.1 (MP), J1.1; also elsewhere on the board
GND: C9.2, C18.2, H10.1 (MP), J1.2, J11.A1 (GND), J11.A12 (GND), J11.B1 (GND), J11.B12 (GND), J11.S1 (SHIELD), R9.2; also elsewhere on the board

Notes on the sheet:
Connectors ------- SDCARD 40way RPI Jumpers Fan
Discharge Resistor Needed by some Type C PSUs
TypeC Power connector
Connectors ------- HDMI 0 HDMI 1 CSI/DSI 0 CSI/DSI 1

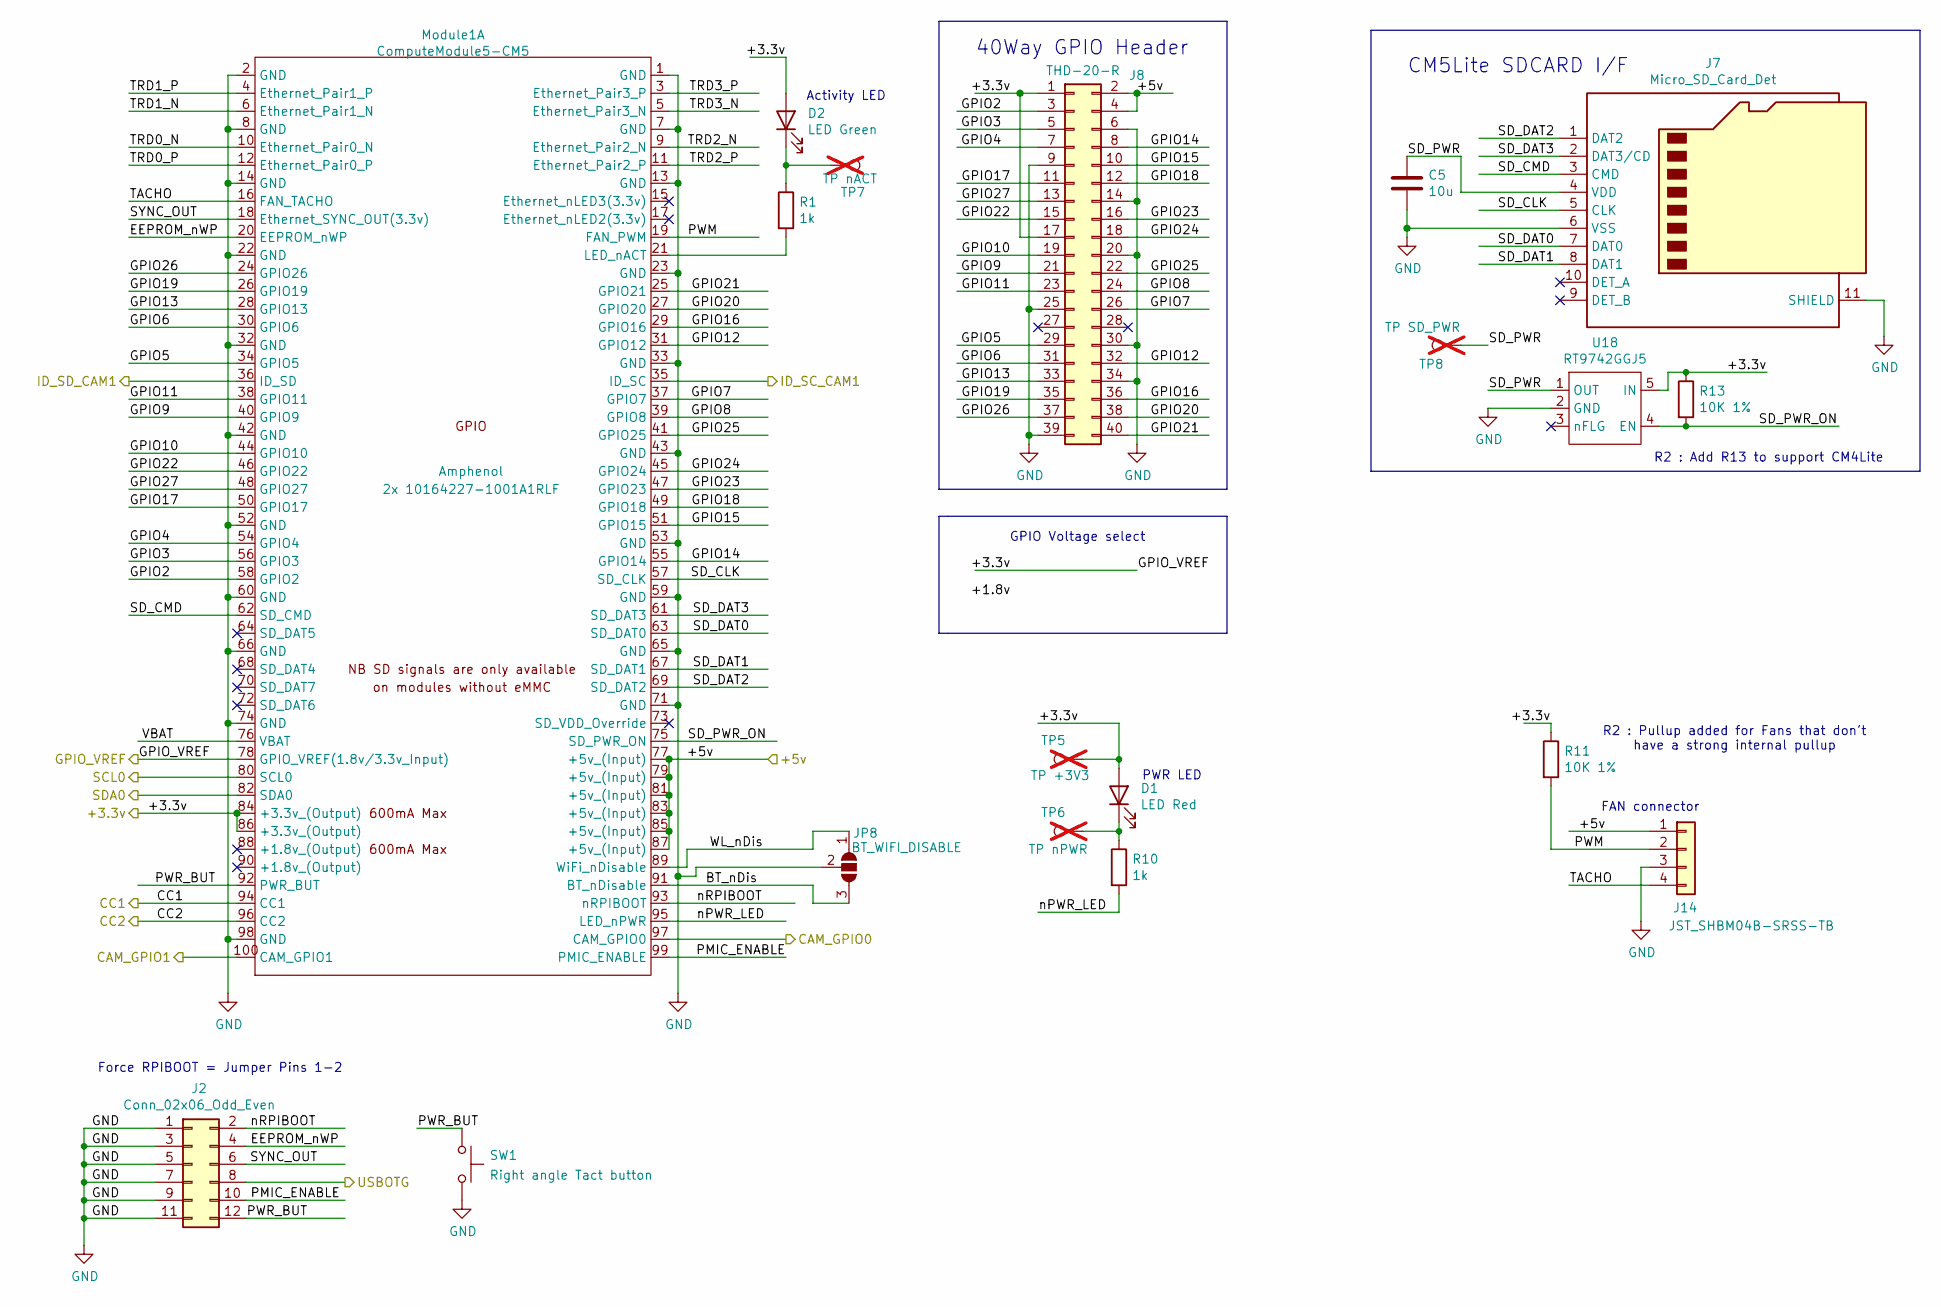
[picture p10: schematic CM5_GPIO.kicad_sch, Compute Module Drone Board]

Parts:
C5: 10u; C_0805_2012Metric; Part Description 10uF 10% 10V Ceramic Capacitor X7R 0805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
D1: LED Red; LED_0603_1608Metric; Part Description Red 620nm LED Indication - Discrete 2.2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
D2: LED Green; LED_0603_1608Metric; Part Description Green 572nm LED Indication - Discrete 2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
J2: Conn_02x06_Odd_Even; PinHeader_2x06_P2.00mm_Vertical; Part Description PinHeader_2x06_P2.54mm_Vertical
J7: Micro_SD_Card_Det; SDCARD_MOLEX_503398-1892; Part Description 9 (8 + 1) Position Card Connector micro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
J8: THD-20-R; PinHeader_2x20_P2.54mm_Vertical; Part Description PinHeader_2x20_P2.54mm_Vertical
J14: JST_SHBM04B-SRSS-TB; JST_SH_BM04B-SRSS-TB_1x04-1MP_P1.00mm_Vertical; Part Description 4 pin vertical 1mm pitch connector
JP8: BT_WIFI_DISABLE; SolderJumper-3_P2.0mm_Open_TrianglePad1.0x1.5mm
Module1: ComputeModule5-CM5; Raspberry-Pi-5-Compute-Module; Part Description 100 Position Connector Receptacle, Cent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
R1, R10: 1k; R_0402_1005Metric; Part Description Resistor 1K M1005 1% 63mW
R11, R13: 10K 1%; R_0402_1005Metric; Part Description Resistor 10K M1005 1% 63mW
SW1: Right angle Tact button; SW_Push_1P1T_NO_CK_KMR2
TP5: TP +3V3; TestPoint_Pad_2.0x2.0mm; Part Description Test point; not fitted
TP6: TP nPWR; TestPoint_Pad_2.0x2.0mm; Part Description Test point; not fitted
TP7: TP nACT; TestPoint_Pad_2.0x2.0mm; Part Description Test point; not fitted
TP8: TP SD_PWR; TestPoint_Pad_2.0x2.0mm; Part Description Test point; not fitted
U18: RT9742GGJ5; SOT-23-5; Part Description Power Switch/Driver 1:1 N-Channel 1A TS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

Connections:
/+3.3v: D1.2 (A), D2.2 (A), J8.1, J8.17, Module1.78 (GPIO_VREF(1.8v/3.3v_Input)), Module1.84 (+3.3v_(Output)), Module1.86 (+3.3v_(Output)), R11.1, R13.1, TP5.1, U18.5 (IN); also elsewhere on the board
/+5v: J8.2, J8.4, J14.1, Module1.77 (+5v_(Input)), Module1.79 (+5v_(Input)), Module1.81 (+5v_(Input)), Module1.83 (+5v_(Input)), Module1.85 (+5v_(Input)), Module1.87 (+5v_(Input)); also elsewhere on the board
/CC1: Module1.94 (CC1); also elsewhere on the board
/CC2: Module1.96 (CC2); also elsewhere on the board
/CM5_GPIO ( Ethernet, GPIO, SDCARD)/BT_nDis: JP8.3 (B), Module1.91 (BT_nDisable)
/CM5_GPIO ( Ethernet, GPIO, SDCARD)/CAM_GPIO0: Module1.97 (CAM_GPIO0); also elsewhere on the board
/CM5_GPIO ( Ethernet, GPIO, SDCARD)/CAM_GPIO1: Module1.100 (CAM_GPIO1); also elsewhere on the board
/CM5_GPIO ( Ethernet, GPIO, SDCARD)/EEPROM_nWP: J2.4, Module1.20 (EEPROM_nWP)
/CM5_GPIO ( Ethernet, GPIO, SDCARD)/GPIO2: J8.3, Module1.58 (GPIO2)
/CM5_GPIO ( Ethernet, GPIO, SDCARD)/GPIO3: J8.5, Module1.56 (GPIO3)
/CM5_GPIO ( Ethernet, GPIO, SDCARD)/GPIO4: J8.7, Module1.54 (GPIO4)
/CM5_GPIO ( Ethernet, GPIO, SDCARD)/GPIO5: J8.29, Module1.34 (GPIO5)
/CM5_GPIO ( Ethernet, GPIO, SDCARD)/GPIO6: J8.31, Module1.30 (GPIO6)
/CM5_GPIO ( Ethernet, GPIO, SDCARD)/GPIO7: J8.26, Module1.37 (GPIO7)
/CM5_GPIO ( Ethernet, GPIO, SDCARD)/GPIO8: J8.24, Module1.39 (GPIO8)
/CM5_GPIO ( Ethernet, GPIO, SDCARD)/GPIO9: J8.21, Module1.40 (GPIO9)
/CM5_GPIO ( Ethernet, GPIO, SDCARD)/GPIO10: J8.19, Module1.44 (GPIO10)
/CM5_GPIO ( Ethernet, GPIO, SDCARD)/GPIO11: J8.23, Module1.38 (GPIO11)
/CM5_GPIO ( Ethernet, GPIO, SDCARD)/GPIO12: J8.32, Module1.31 (GPIO12)
/CM5_GPIO ( Ethernet, GPIO, SDCARD)/GPIO13: J8.33, Module1.28 (GPIO13)
/CM5_GPIO ( Ethernet, GPIO, SDCARD)/GPIO14: J8.8, Module1.55 (GPIO14)
/CM5_GPIO ( Ethernet, GPIO, SDCARD)/GPIO15: J8.10, Module1.51 (GPIO15)
/CM5_GPIO ( Ethernet, GPIO, SDCARD)/GPIO16: J8.36, Module1.29 (GPIO16)
/CM5_GPIO ( Ethernet, GPIO, SDCARD)/GPIO17: J8.11, Module1.50 (GPIO17)
/CM5_GPIO ( Ethernet, GPIO, SDCARD)/GPIO18: J8.12, Module1.49 (GPIO18)
/CM5_GPIO ( Ethernet, GPIO, SDCARD)/GPIO19: J8.35, Module1.26 (GPIO19)
/CM5_GPIO ( Ethernet, GPIO, SDCARD)/GPIO20: J8.38, Module1.27 (GPIO20)
/CM5_GPIO ( Ethernet, GPIO, SDCARD)/GPIO21: J8.40, Module1.25 (GPIO21)
/CM5_GPIO ( Ethernet, GPIO, SDCARD)/GPIO22: J8.15, Module1.46 (GPIO22)
/CM5_GPIO ( Ethernet, GPIO, SDCARD)/GPIO23: J8.16, Module1.47 (GPIO23)
/CM5_GPIO ( Ethernet, GPIO, SDCARD)/GPIO24: J8.18, Module1.45 (GPIO24)
/CM5_GPIO ( Ethernet, GPIO, SDCARD)/GPIO25: J8.22, Module1.41 (GPIO25)
/CM5_GPIO ( Ethernet, GPIO, SDCARD)/GPIO26: J8.37, Module1.24 (GPIO26)
/CM5_GPIO ( Ethernet, GPIO, SDCARD)/GPIO27: J8.13, Module1.48 (GPIO27)
/CM5_GPIO ( Ethernet, GPIO, SDCARD)/PMIC_ENABLE: J2.10, Module1.99 (PMIC_ENABLE)
/CM5_GPIO ( Ethernet, GPIO, SDCARD)/PWM: J14.2, Module1.19 (FAN_PWM), R11.2
/CM5_GPIO ( Ethernet, GPIO, SDCARD)/PWR_BUT: J2.12, Module1.92 (PWR_BUT), SW1.1
/CM5_GPIO ( Ethernet, GPIO, SDCARD)/SD_CLK: J7.5 (CLK), Module1.57 (SD_CLK)
/CM5_GPIO ( Ethernet, GPIO, SDCARD)/SD_CMD: J7.3 (CMD), Module1.62 (SD_CMD)
/CM5_GPIO ( Ethernet, GPIO, SDCARD)/SD_DAT0: J7.7 (DAT0), Module1.63 (SD_DAT0)
/CM5_GPIO ( Ethernet, GPIO, SDCARD)/SD_DAT1: J7.8 (DAT1), Module1.67 (SD_DAT1)
/CM5_GPIO ( Ethernet, GPIO, SDCARD)/SD_DAT2: J7.1 (DAT2), Module1.69 (SD_DAT2)
/CM5_GPIO ( Ethernet, GPIO, SDCARD)/SD_DAT3: J7.2 (DAT3/CD), Module1.61 (SD_DAT3)
/CM5_GPIO ( Ethernet, GPIO, SDCARD)/SD_PWR: C5.1, J7.4 (VDD), TP8.1, U18.1 (OUT)
/CM5_GPIO ( Ethernet, GPIO, SDCARD)/SD_PWR_ON: Module1.75 (SD_PWR_ON), R13.2, U18.4 (EN)
/CM5_GPIO ( Ethernet, GPIO, SDCARD)/SYNC_OUT: J2.6, Module1.18 (Ethernet_SYNC_OUT(3.3v))
/CM5_GPIO ( Ethernet, GPIO, SDCARD)/TACHO: J14.4, Module1.16 (FAN_TACHO)
/CM5_GPIO ( Ethernet, GPIO, SDCARD)/TRD0_N: Module1.10 (Ethernet_Pair0_N)
/CM5_GPIO ( Ethernet, GPIO, SDCARD)/TRD0_P: Module1.12 (Ethernet_Pair0_P)
/CM5_GPIO ( Ethernet, GPIO, SDCARD)/TRD1_N: Module1.6 (Ethernet_Pair1_N)
/CM5_GPIO ( Ethernet, GPIO, SDCARD)/TRD1_P: Module1.4 (Ethernet_Pair1_P)
/CM5_GPIO ( Ethernet, GPIO, SDCARD)/TRD2_N: Module1.9 (Ethernet_Pair2_N)
/CM5_GPIO ( Ethernet, GPIO, SDCARD)/TRD2_P: Module1.11 (Ethernet_Pair2_P)
/CM5_GPIO ( Ethernet, GPIO, SDCARD)/TRD3_N: Module1.5 (Ethernet_Pair3_N)
/CM5_GPIO ( Ethernet, GPIO, SDCARD)/TRD3_P: Module1.3 (Ethernet_Pair3_P)
/CM5_GPIO ( Ethernet, GPIO, SDCARD)/USBOTG: J2.8; also elsewhere on the board
/CM5_GPIO ( Ethernet, GPIO, SDCARD)/VBAT: Module1.76 (VBAT)
/CM5_GPIO ( Ethernet, GPIO, SDCARD)/WL_nDis: JP8.1 (A), Module1.89 (WiFi_nDisable)
/CM5_GPIO ( Ethernet, GPIO, SDCARD)/nPWR_LED: Module1.95 (LED_nPWR), R10.2
/CM5_GPIO ( Ethernet, GPIO, SDCARD)/nRPIBOOT: J2.2, Module1.93 (nRPIBOOT)
/CM5_HighSpeed/SCL0: Module1.80 (SCL0); also elsewhere on the board
/CM5_HighSpeed/SCL1: Module1.35 (ID_SC); also elsewhere on the board
/CM5_HighSpeed/SDA0: Module1.82 (SDA0); also elsewhere on the board
/CM5_HighSpeed/SDA1: Module1.36 (ID_SD); also elsewhere on the board
GND: C5.2, J2.1, J2.3, J2.5, J2.7, J2.9, J2.11, J7.6 (VSS), J7.11 (SHIELD), J8.6, J8.9, J8.14, J8.20, J8.25, J8.30, J8.34, J8.39, J14.3, JP8.2 (C), Module1.1 (GND), Module1.2 (GND), Module1.7 (GND), Module1.8 (GND), Module1.13 (GND), Module1.14 (GND), Module1.22 (GND), Module1.23 (GND), Module1.32 (GND), Module1.33 (GND), Module1.42 (GND), Module1.43 (GND), Module1.52 (GND), Module1.53 (GND), Module1.59 (GND), Module1.60 (GND), Module1.65 (GND), Module1.66 (GND), Module1.71 (GND), Module1.74 (GND), Module1.98 (GND), SW1.2, U18.2 (GND); also elsewhere on the board
unnamed: D1.1 (K), R10.1, TP6.1
unnamed: D2.1 (K), R1.1, TP7.1
unnamed: Module1.21 (LED_nACT), R1.2

Notes on the sheet:
40Way GPIO Header
R2 : Pullup added for Fans that don't have a strong internal pullup
Activity LED
R2 : Add R13 to support CM4Lite
GPIO Voltage select
Force RPIBOOT = Jumper Pins 1-2
PWR LED
FAN connector
CM5Lite SDCARD I/F
