AGH-Drone-Engineering/RPi_CM_Drone_Board/pcb_CMDB_rev1/CM5IO.kicad_pcb

## KiCad design pcb_CMDB_rev1/CM5IO.kicad_pcb (continued)

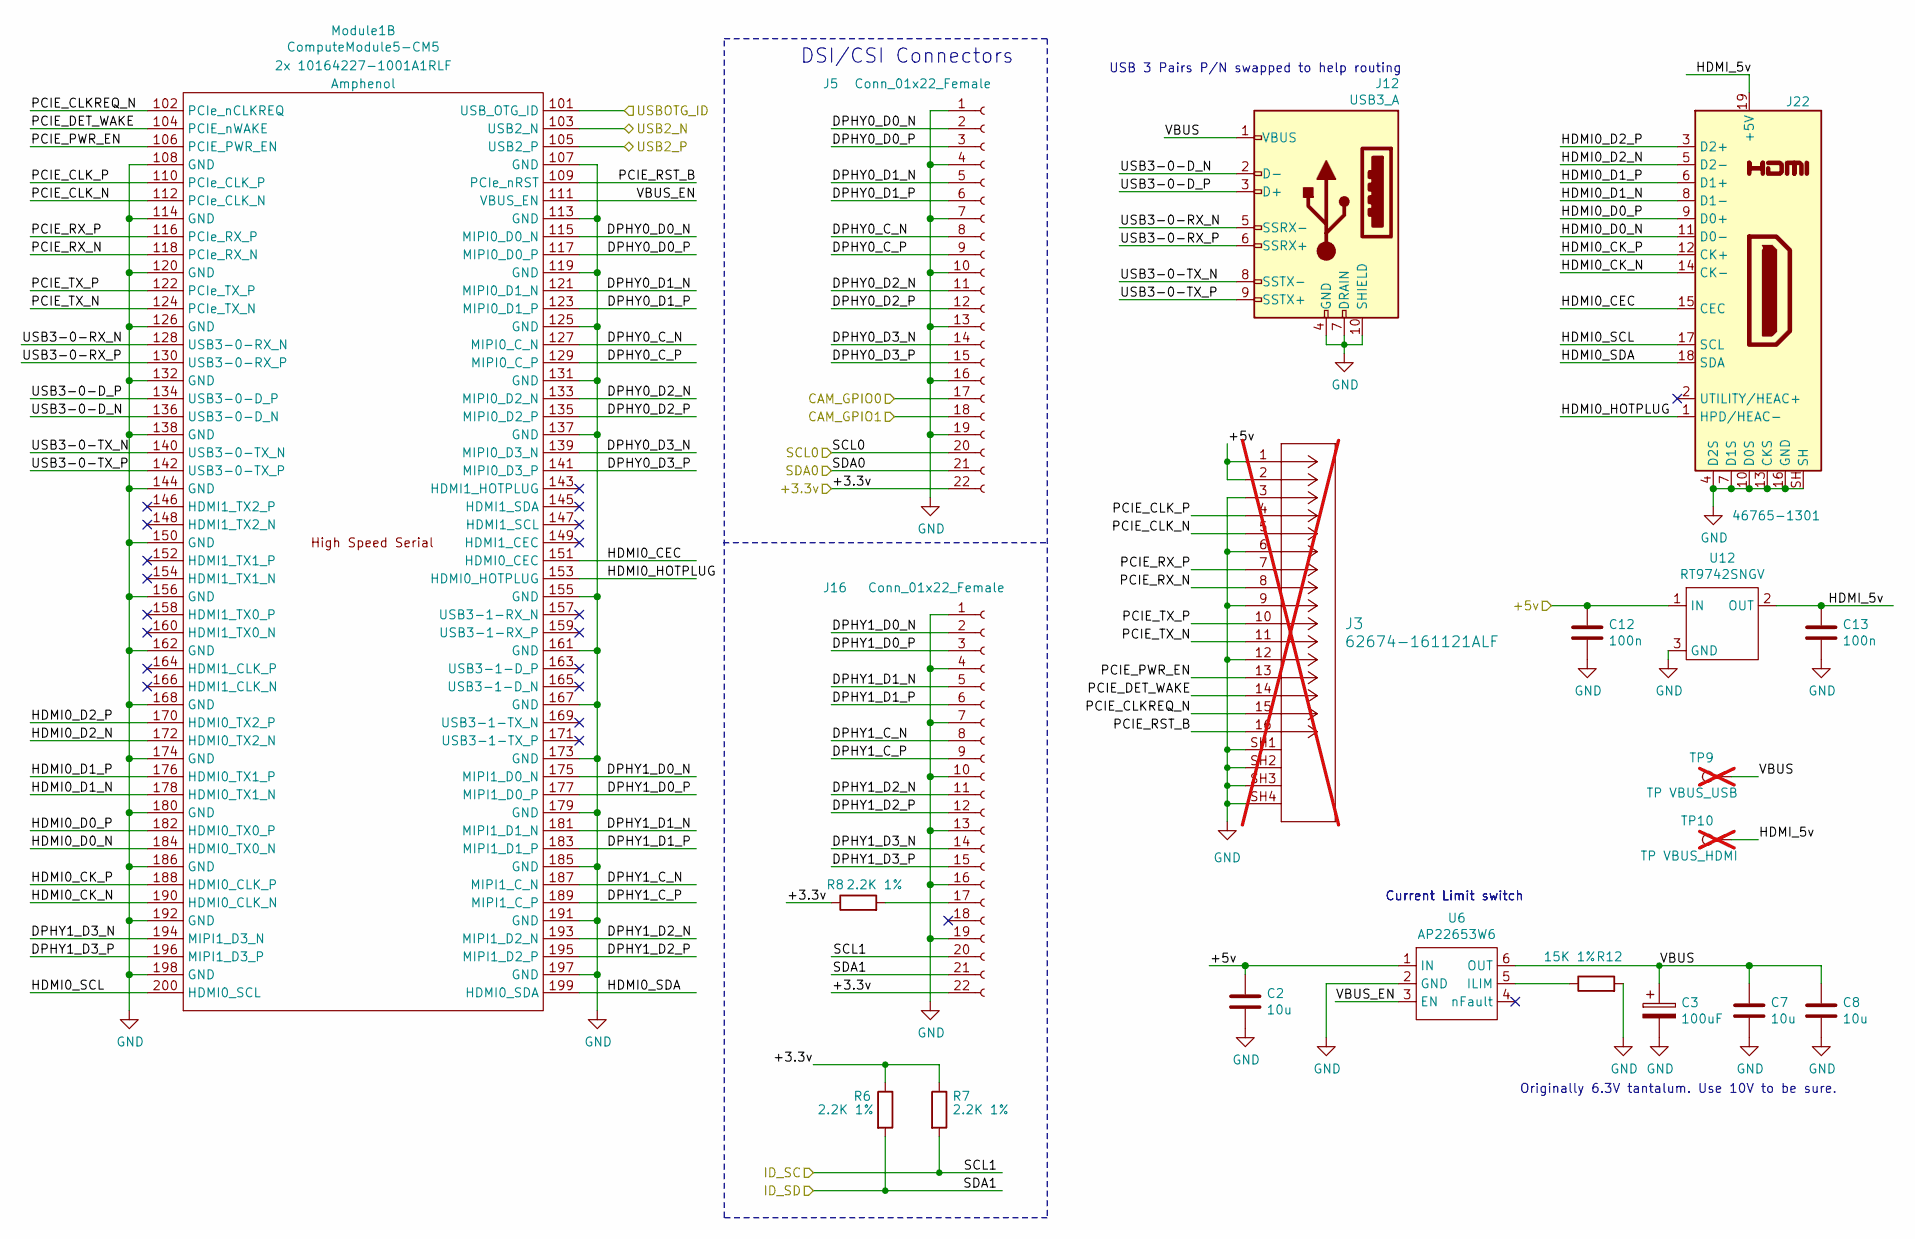
[picture p11: schematic CM5_HighSpeed.kicad_sch, Compute Module Drone Board]

Parts:
C2, C7, C8: 10u; C_0805_2012Metric; Part Description 10uF 10% 10V Ceramic Capacitor X7R 0805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
C3: 100uF; CP_EIA-7343-31_Kemet-D; Part Description Capacitor, SP-Cap, 100u, 6.3V, 15mR ESR
C12, C13: 100n; C_0402_1005Metric; Part Description 0.1uF 10% 16V Ceramic Capacitor X7R 040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
J3: 62674-161121ALF; CON16_1X16_DUT_58XF_GLE; not fitted
J5, J16: Conn_01x22_Female; Hirose_FH12-22S-0.5SH_1x22-1MP_P0.50mm_Horizontal; Part Description 22 Position FFC, FPC Connector Contacts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
J12: USB3_A; USB3_A_Molex_48393-001; Part Description USB 3.0 A connector
J22: 46765-1301; CONN_467651301_MOL; Part Description 0.40mm Pitch Micro HDMI Connector, Righ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
Module1: ComputeModule5-CM5; Raspberry-Pi-5-Compute-Module; Part Description 100 Position Connector Receptacle, Cent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
R6, R7, R8: 2.2K 1%; R_0402_1005Metric; Part Description Resistor 2.2K M1005 1% 63mW
R12: 15K 1%; R_0402_1005Metric; Part Description Resistor 15K M1005 1% 63mW
TP9: TP VBUS_USB; TestPoint_Pad_2.0x2.0mm; Part Description Test point; not fitted
TP10: TP VBUS_HDMI; TestPoint_Pad_2.0x2.0mm; Part Description Test point; not fitted
U6: AP22653W6; SOT-23-6; Part Description Power Switch/Driver 1:1 P-Channel 2.1A 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
U12: RT9742SNGV; TSOT-23_HandSoldering; Part Description Power Switch/Driver 1:1 N-Channel 500mA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

Connections:
/+3.3v: J5.22, J16.22, R6.1, R7.1, R8.1; also elsewhere on the board
/+5v: C2.1, C12.1, J3.1, J3.2, U6.1 (IN), U12.1 (IN); also elsewhere on the board
/CM5_GPIO ( Ethernet, GPIO, SDCARD)/CAM_GPIO0: J5.17; also elsewhere on the board
/CM5_GPIO ( Ethernet, GPIO, SDCARD)/CAM_GPIO1: J5.18; also elsewhere on the board
/CM5_GPIO ( Ethernet, GPIO, SDCARD)/USBOTG: Module1.101 (USB_OTG_ID); also elsewhere on the board
/CM5_HighSpeed/DPHY0_C_N: J5.8, Module1.127 (MIPI0_C_N)
/CM5_HighSpeed/DPHY0_C_P: J5.9, Module1.129 (MIPI0_C_P)
/CM5_HighSpeed/DPHY0_D0_N: J5.2, Module1.115 (MIPI0_D0_N)
/CM5_HighSpeed/DPHY0_D0_P: J5.3, Module1.117 (MIPI0_D0_P)
/CM5_HighSpeed/DPHY0_D1_N: J5.5, Module1.121 (MIPI0_D1_N)
/CM5_HighSpeed/DPHY0_D1_P: J5.6, Module1.123 (MIPI0_D1_P)
/CM5_HighSpeed/DPHY0_D2_N: J5.11, Module1.133 (MIPI0_D2_N)
/CM5_HighSpeed/DPHY0_D2_P: J5.12, Module1.135 (MIPI0_D2_P)
/CM5_HighSpeed/DPHY0_D3_N: J5.14, Module1.139 (MIPI0_D3_N)
/CM5_HighSpeed/DPHY0_D3_P: J5.15, Module1.141 (MIPI0_D3_P)
/CM5_HighSpeed/DPHY1_C_N: J16.8, Module1.187 (MIPI1_C_N)
/CM5_HighSpeed/DPHY1_C_P: J16.9, Module1.189 (MIPI1_C_P)
/CM5_HighSpeed/DPHY1_D0_N: J16.2, Module1.175 (MIPI1_D0_N)
/CM5_HighSpeed/DPHY1_D0_P: J16.3, Module1.177 (MIPI1_D0_P)
/CM5_HighSpeed/DPHY1_D1_N: J16.5, Module1.181 (MIPI1_D1_N)
/CM5_HighSpeed/DPHY1_D1_P: J16.6, Module1.183 (MIPI1_D1_P)
/CM5_HighSpeed/DPHY1_D2_N: J16.11, Module1.193 (MIPI1_D2_N)
/CM5_HighSpeed/DPHY1_D2_P: J16.12, Module1.195 (MIPI1_D2_P)
/CM5_HighSpeed/DPHY1_D3_N: J16.14, Module1.194 (MIPI1_D3_N)
/CM5_HighSpeed/DPHY1_D3_P: J16.15, Module1.196 (MIPI1_D3_P)
/CM5_HighSpeed/HDMI0_CEC: J22.15 (CEC), Module1.151 (HDMI0_CEC)
/CM5_HighSpeed/HDMI0_CK_N: J22.14 (CK-), Module1.190 (HDMI0_CLK_N)
/CM5_HighSpeed/HDMI0_CK_P: J22.12 (CK+), Module1.188 (HDMI0_CLK_P)
/CM5_HighSpeed/HDMI0_D0_N: J22.11 (D0-), Module1.184 (HDMI0_TX0_N)
/CM5_HighSpeed/HDMI0_D0_P: J22.9 (D0+), Module1.182 (HDMI0_TX0_P)
/CM5_HighSpeed/HDMI0_D1_N: J22.8 (D1-), Module1.178 (HDMI0_TX1_N)
/CM5_HighSpeed/HDMI0_D1_P: J22.6 (D1+), Module1.176 (HDMI0_TX1_P)
/CM5_HighSpeed/HDMI0_D2_N: J22.5 (D2-), Module1.172 (HDMI0_TX2_N)
/CM5_HighSpeed/HDMI0_D2_P: J22.3 (D2+), Module1.170 (HDMI0_TX2_P)
/CM5_HighSpeed/HDMI0_HOTPLUG: J22.1 (HPD/HEAC-), Module1.153 (HDMI0_HOTPLUG)
/CM5_HighSpeed/HDMI0_SCL: J22.17 (SCL), Module1.200 (HDMI0_SCL)
/CM5_HighSpeed/HDMI0_SDA: J22.18 (SDA), Module1.199 (HDMI0_SDA)
/CM5_HighSpeed/HDMI_5v: C13.1, J22.19 (+5V), TP10.1, U12.2 (OUT)
/CM5_HighSpeed/PCIE_CLKREQ_N: J3.15, Module1.102 (PCIe_nCLKREQ)
/CM5_HighSpeed/PCIE_CLK_N: J3.5, Module1.112 (PCIe_CLK_N)
/CM5_HighSpeed/PCIE_CLK_P: J3.4, Module1.110 (PCIe_CLK_P)
/CM5_HighSpeed/PCIE_DET_WAKE: J3.14, Module1.104 (PCIE_nWAKE)
/CM5_HighSpeed/PCIE_PWR_EN: J3.13, Module1.106 (PCIE_PWR_EN)
/CM5_HighSpeed/PCIE_RST_B: J3.16, Module1.109 (PCIe_nRST)
/CM5_HighSpeed/PCIE_RX_N: J3.8, Module1.118 (PCIe_RX_N)
/CM5_HighSpeed/PCIE_RX_P: J3.7, Module1.116 (PCIe_RX_P)
/CM5_HighSpeed/PCIE_TX_N: J3.11, Module1.124 (PCIe_TX_N)
/CM5_HighSpeed/PCIE_TX_P: J3.10, Module1.122 (PCIe_TX_P)
/CM5_HighSpeed/SCL0: J5.20; also elsewhere on the board
/CM5_HighSpeed/SCL1: J16.20, R7.2; also elsewhere on the board
/CM5_HighSpeed/SDA0: J5.21; also elsewhere on the board
/CM5_HighSpeed/SDA1: J16.21, R6.2; also elsewhere on the board
/CM5_HighSpeed/USB3-0-D_N: J12.2 (D-), Module1.136 (USB3-0-D_N)
/CM5_HighSpeed/USB3-0-D_P: J12.3 (D+), Module1.134 (USB3-0-D_P)
/CM5_HighSpeed/USB3-0-RX_N: J12.5 (SSRX-), Module1.128 (USB3-0-RX_N)
/CM5_HighSpeed/USB3-0-RX_P: J12.6 (SSRX+), Module1.130 (USB3-0-RX_P)
/CM5_HighSpeed/USB3-0-TX_N: J12.8 (SSTX-), Module1.140 (USB3-0-TX_N)
/CM5_HighSpeed/USB3-0-TX_P: J12.9 (SSTX+), Module1.142 (USB3-0-TX_P)
/CM5_HighSpeed/VBUS: C3.1, C7.1, C8.1, J12.1 (VBUS), TP9.1, U6.6 (OUT)
/CM5_HighSpeed/VBUS_EN: Module1.111 (VBUS_EN), U6.3 (EN)
/USB2_N: Module1.103 (USB2_N); also elsewhere on the board
/USB2_P: Module1.105 (USB2_P); also elsewhere on the board
GND: C2.2, C3.2, C7.2, C8.2, C12.2, C13.2, J3.3, J3.6, J3.9, J3.12, J3.SH1, J3.SH2, J3.SH3, J3.SH4, J5.1, J5.4, J5.7, J5.10, J5.13, J5.16, J5.19, J12.4 (GND), J12.7 (DRAIN), J12.10 (SHIELD), J16.1, J16.4, J16.7, J16.10, J16.13, J16.16, J16.19, J22.4 (D2S), J22.7 (D1S), J22.10 (D0S), J22.13 (CKS), J22.16 (GND), J22.SH, Module1.107 (GND), Module1.108 (GND), Module1.113 (GND), Module1.114 (GND), Module1.119 (GND), Module1.120 (GND), Module1.125 (GND), Module1.126 (GND), Module1.131 (GND), Module1.132 (GND), Module1.137 (GND), Module1.138 (GND), Module1.144 (GND), Module1.150 (GND), Module1.155 (GND), Module1.156 (GND), Module1.161 (GND), Module1.162 (GND), Module1.167 (GND), Module1.168 (GND), Module1.173 (GND), Module1.174 (GND), Module1.179 (GND), Module1.180 (GND), Module1.185 (GND), Module1.186 (GND), Module1.191 (GND), Module1.192 (GND), Module1.197 (GND), Module1.198 (GND), R12.2, U6.2 (GND), U12.3 (GND); also elsewhere on the board
unnamed: J16.17, R8.2
unnamed: R12.1, U6.5 (ILIM)

Notes on the sheet:
USB 3 Pairs P/N swapped to help routing
Current Limit switch
DSI/CSI Connectors
Originally 6.3V tantalum. Use 10V to be sure.

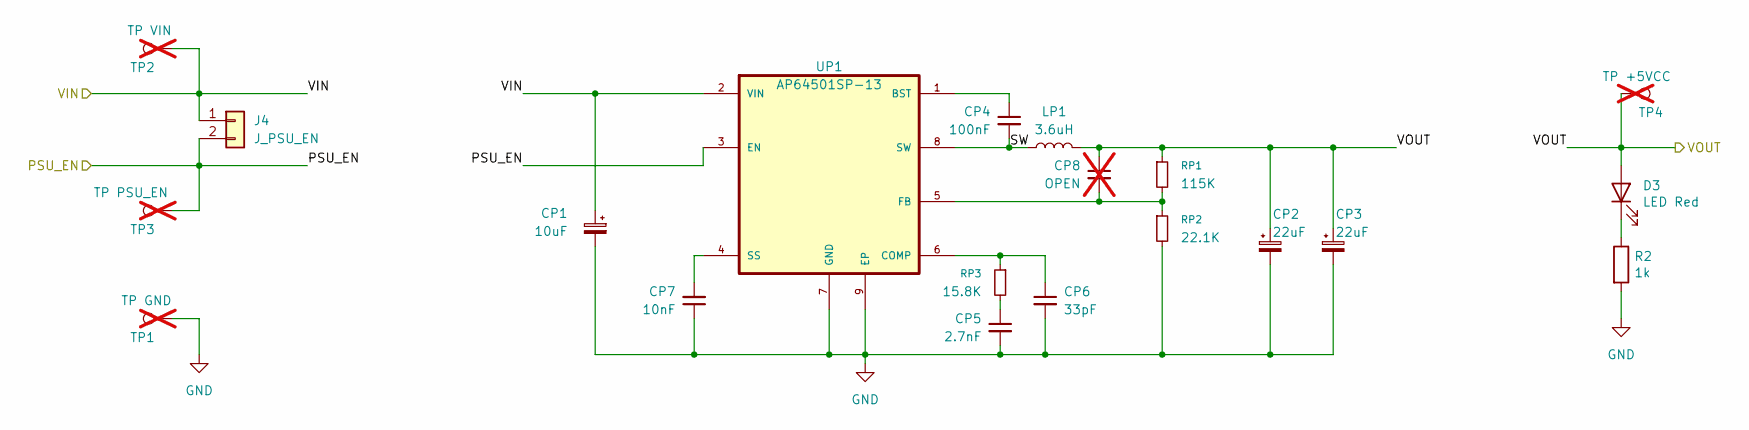
[picture p12: schematic psu.kicad_sch, Compute Module Drone Board]

Parts:
CP1: 10uF; CP_EIA-6032-28_Kemet-C_HandSolder
CP2, CP3: 22uF; CP_EIA-3528-21_Kemet-B_HandSolder
CP4: 100nF; C_0805_2012Metric_Pad1.18x1.45mm_HandSolder
CP5: 2.7nF; C_0805_2012Metric_Pad1.18x1.45mm_HandSolder
CP6: 33pF; C_0805_2012Metric_Pad1.18x1.45mm_HandSolder
CP7: 10nF; C_0805_2012Metric_Pad1.18x1.45mm_HandSolder
CP8: OPEN; C_0805_2012Metric_Pad1.18x1.45mm_HandSolder; not fitted
D3: LED Red; LED_0603_1608Metric; Part Description Red 620nm LED Indication - Discrete 2.2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
J4: J_PSU_EN; PinHeader_1x02_P2.54mm_Vertical
LP1: 3.6uH; L_Bourns-SRN8040_8x8.15mm
R2: 1k; R_0402_1005Metric; Part Description Resistor 1K M1005 1% 63mW
RP1: 115K; R_0805_2012Metric_Pad1.20x1.40mm_HandSolder
RP2: 22.1K; R_0805_2012Metric_Pad1.20x1.40mm_HandSolder
RP3: 15.8K; R_0805_2012Metric_Pad1.20x1.40mm_HandSolder
TP1: TP GND; TestPoint_Pad_2.0x2.0mm; Part Description Test point; not fitted
TP2: TP VIN; TestPoint_Pad_2.0x2.0mm; Part Description Test point; not fitted
TP3: TP PSU_EN; TestPoint_Pad_2.0x2.0mm; Part Description Test point; not fitted
TP4: TP +5VCC; TestPoint_Pad_2.0x2.0mm; Part Description Test point; not fitted
UP1: AP64501SP-13; SOP_AP64501SP-13_DIO

Connections:
/+5v: CP2.1, CP3.1, CP8.1, D3.2 (A), LP1.2, RP1.1, TP4.1; also elsewhere on the board
/PSU/PSU_EN: J4.2, TP3.1, UP1.3 (EN)
/PSU/SW: CP4.2, LP1.1, UP1.8 (SW)
/VIN: CP1.1, J4.1, TP2.1, UP1.2 (VIN); also elsewhere on the board
GND: CP1.2, CP2.2, CP3.2, CP5.2, CP6.2, CP7.1, R2.2, RP2.2, TP1.1, UP1.7 (GND), UP1.9 (EP); also elsewhere on the board
unnamed: CP5.1, RP3.2
unnamed: D3.1 (K), R2.1
unnamed: CP4.1, UP1.1 (BST)
unnamed: CP6.1, RP3.1, UP1.6 (COMP)
unnamed: CP8.2, RP1.2, RP2.1, UP1.5 (FB)
unnamed: CP7.2, UP1.4 (SS)

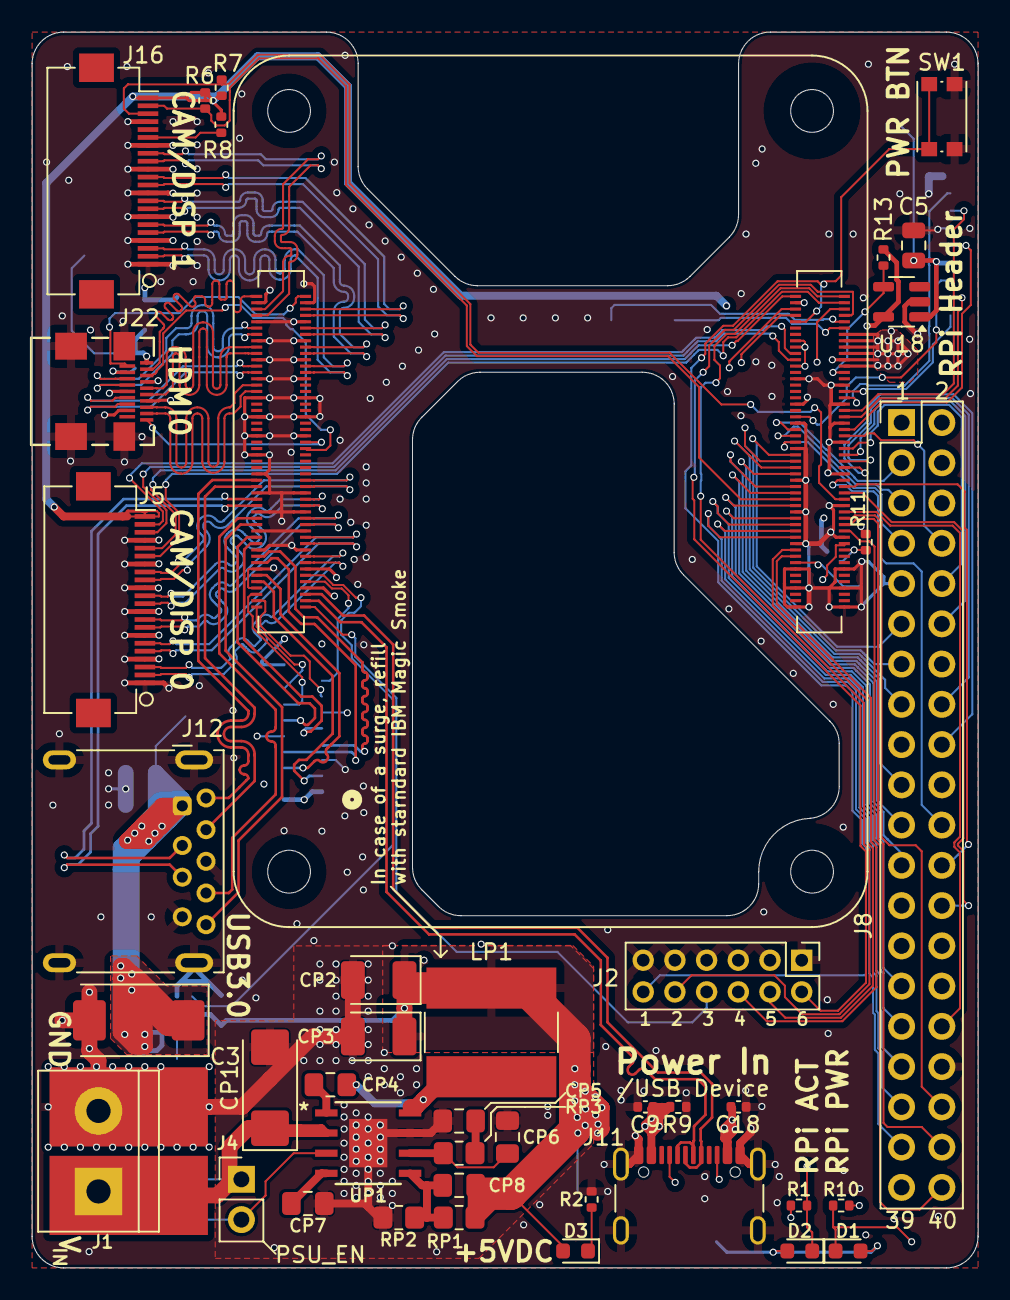
[picture p13: board CM5IO.kicad_pcb from above]

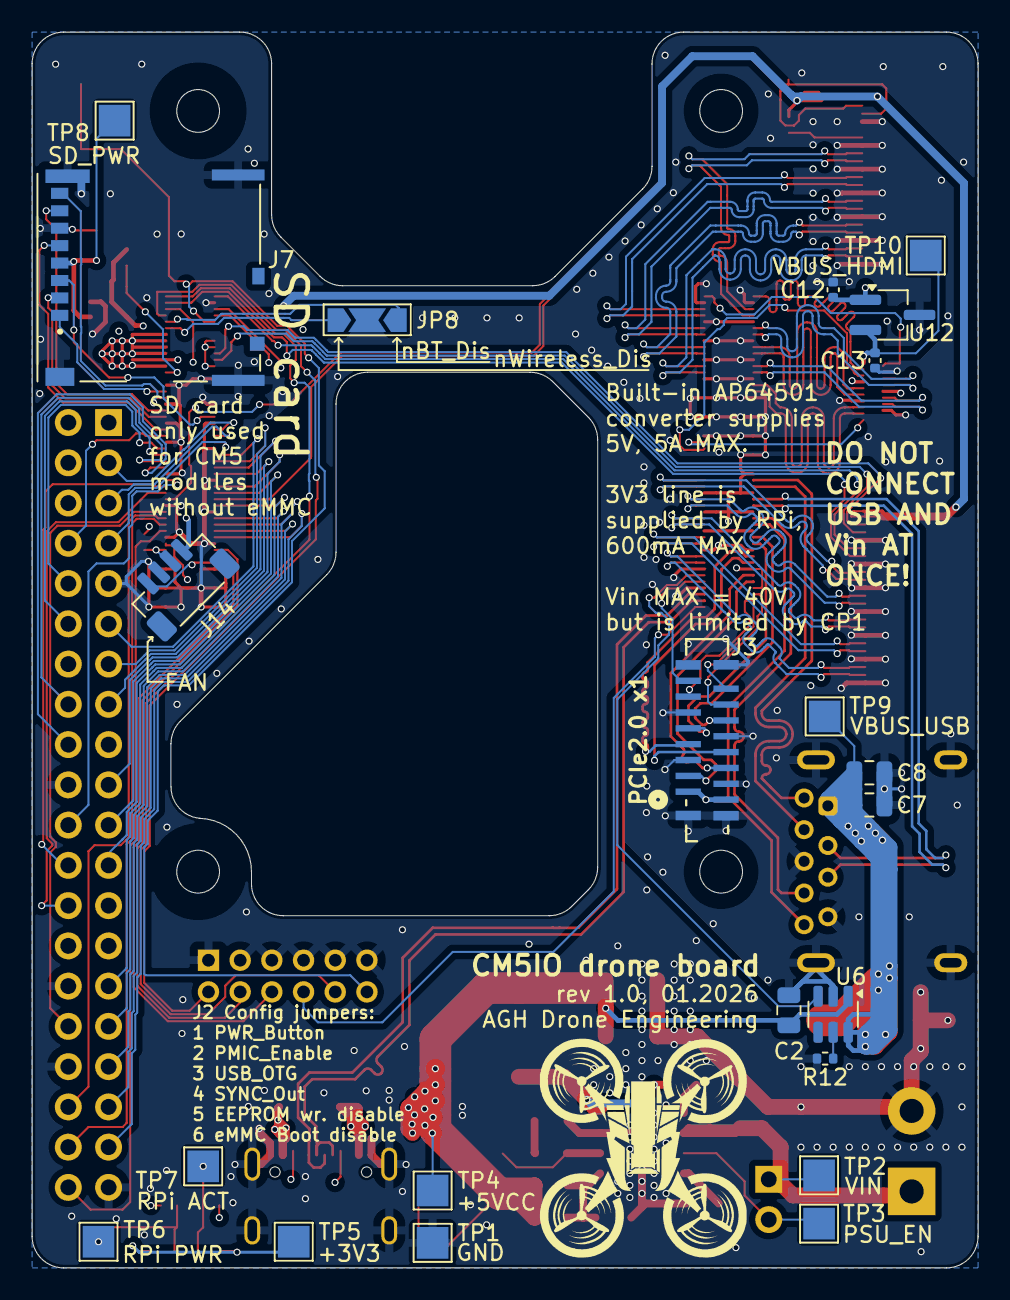
[picture p14: board CM5IO.kicad_pcb from below]

Board: 4 copper layers, 59.7 x 78.0 mm, 65 parts (22 on the bottom side), 123 nets.
