AGH-Drone-Engineering/RPi_CM_Drone_Board/firmware_CMDB/loracom/LoRaCom.cpp

#include "LoRaCom.h"

#include <cerrno>
#include <chrono>
#include <system_error>

// TYPE[1] | SENDER_ID[1] | LENGTH[4, little-endian] | PAYLOAD[LENGTH] | CHECKSUM[2, little-endian]
std::vector<uint8_t> LoRaCom::buildFrame(TransmissionType type, uint8_t id, const std::string& payload)
{
    std::vector<uint8_t> crcInput;
    crcInput.reserve(2 + payload.size());
    crcInput.push_back(static_cast<uint8_t>(type));
    crcInput.push_back(id);
    crcInput.insert(crcInput.end(), payload.begin(), payload.end());
    uint16_t checksum = getCRC(crcInput);

    std::vector<uint8_t> frame;
    frame.reserve(6 + payload.size() + 2);
    frame.push_back(static_cast<uint8_t>(type));
    frame.push_back(id);
    frame.push_back(payload.size() & 0xFF);
    frame.push_back((payload.size() >> 8) & 0xFF);
    frame.push_back((payload.size() >> 16) & 0xFF);
    frame.push_back((payload.size() >> 24) & 0xFF);
    frame.insert(frame.end(), payload.begin(), payload.end());
    frame.push_back(checksum & 0xFF);
    frame.push_back((checksum >> 8) & 0xFF);
    return frame;
}

std::optional<LoRaCom::ParsedFrame> LoRaCom::readFrame(uint32_t timeoutMs)
{
    const auto deadline = std::chrono::steady_clock::now() + std::chrono::milliseconds(timeoutMs);

    for (;;) {
        // Try to carve a complete frame out of what we already have.
        while (rxBuf_.size() >= 6) {
            // Cast before shifting: a uint8_t promotes to int, so a top byte
            // of 0x80 or more would overflow the sign bit - undefined
            // behaviour, not the wrapped value the expression looks like.
            uint32_t length = static_cast<uint32_t>(rxBuf_[2]) |
                              (static_cast<uint32_t>(rxBuf_[3]) << 8) |
                              (static_cast<uint32_t>(rxBuf_[4]) << 16) |
                              (static_cast<uint32_t>(rxBuf_[5]) << 24);

            if (length > MAX_FRAME_PAYLOAD) {
                // Not a plausible header - we're mid-garbage. Drop one byte and
                // try to resync on the next one, same as the HAT's parser does.
                rxBuf_.erase(rxBuf_.begin());
                continue;
            }

            size_t frameSize = 6 + length + 2;
            if (rxBuf_.size() < frameSize) {
                break; // header looks sane, keep reading the rest
            }

            uint16_t receivedChecksum = rxBuf_[6 + length] | (rxBuf_[6 + length + 1] << 8);

            ParsedFrame frame;
            frame.type = static_cast<TransmissionType>(rxBuf_[0]);
            frame.senderId = rxBuf_[1];
            frame.payload = std::string(rxBuf_.begin() + 6, rxBuf_.begin() + 6 + length);
            frame.checksumValid = verifyChecksum(frame, receivedChecksum);

            // Keep anything that followed this frame for the next call.
            rxBuf_.erase(rxBuf_.begin(), rxBuf_.begin() + frameSize);
            return frame;
        }

        auto remaining = std::chrono::duration_cast<std::chrono::milliseconds>(
            deadline - std::chrono::steady_clock::now());
        std::vector<uint8_t> chunk;
        if (remaining.count() > 0) {
            chunk = this->read(static_cast<uint32_t>(remaining.count()));
        }

        if (chunk.empty()) {
            // Timed out (or EOF) with the line quiet mid-frame. Those leftover
            // bytes will never complete - drop them so they can't be glued onto
            // the next reply and corrupt it. Mirrors the HAT parser's
            // FRAME_IDLE_TIMEOUT_MS reset.
            rxBuf_.clear();
            return std::nullopt;
        }
        rxBuf_.insert(rxBuf_.end(), chunk.begin(), chunk.end());
    }
}

std::optional<LoRaCom::ParsedFrame> LoRaCom::awaitReply(bool force)
{
    std::optional<ParsedFrame> reply = readFrame(timeoutMs_);
    if (force) {
        return reply; // accept it as-is, bad checksum or not
    }
    if (reply && !reply->checksumValid) {
        // Corrupted frame - the far end likely already replied and will
        // retransmit on its own once it notices we never ACKed. Wait longer
        // for that retransmission instead of immediately resending our request.
        reply = readFrame(2 * timeoutMs_);
    }
    if (reply && !reply->checksumValid) {
        reply = std::nullopt;
    }
    return reply;
}

void LoRaCom::sendAck()
{
    this->write(buildFrame(TransmissionType::ACK, 0, ""));
}

// CRC-16/XMODEM: poly 0x1021, init 0x0000, no reflect, no xorout.
// Must match firmware_IARC_HAT/src/node/UartRfBridge.cpp::crc16 byte-for-byte.
uint16_t LoRaCom::getCRC(const std::vector<uint8_t>& data)
{
    uint16_t crc = 0x0000;
    for (uint8_t byte : data) {
        crc ^= static_cast<uint16_t>(byte) << 8;
        for (int i = 0; i < 8; ++i) {
            crc = (crc & 0x8000) ? static_cast<uint16_t>((crc << 1) ^ 0x1021) : static_cast<uint16_t>(crc << 1);
        }
    }
    return crc;
}

bool LoRaCom::verifyChecksum(const ParsedFrame& frame, uint16_t receivedChecksum)
{
    std::vector<uint8_t> data;
    data.reserve(2 + frame.payload.size());
    data.push_back(static_cast<uint8_t>(frame.type));
    data.push_back(frame.senderId);
    data.insert(data.end(), frame.payload.begin(), frame.payload.end());
    return getCRC(data) == receivedChecksum;
}

bool LoRaCom::sendTransmission(TransmissionType type, uint8_t destId, const std::string& payload)
{
    std::vector<uint8_t> frame = buildFrame(type, destId, payload);

    for (uint32_t attempt = 0; attempt <= maxRetries_; ++attempt) {
        this->write(frame);

        std::optional<ParsedFrame> reply = awaitReply();
        if (reply && reply->type == TransmissionType::ACK) {
            return true;
        }
        // timeout, corrupted frame, or unexpected reply -> retransmit
    }
    throw std::system_error(EREMOTEIO, std::generic_category(), "sendTransmission");
}

std::optional<Transmission> LoRaCom::getTransmission(TransmissionType type, bool force)
{
    std::vector<uint8_t> request = buildFrame(type, 0, "");

    for (uint32_t attempt = 0; attempt <= maxRetries_; ++attempt) {
        this->write(request);

        std::optional<ParsedFrame> reply = awaitReply(force);
        if (!reply) {
            continue; // timeout -> retransmit request
        }
        if (reply->type == TransmissionType::ACK) {
            return std::nullopt; // queue empty
        }
        if (reply->type != type) {
            continue; // unexpected reply -> retransmit request
        }

        sendAck();
        return Transmission{reply->senderId, reply->payload};
    }
    throw std::system_error(EREMOTEIO, std::generic_category(), "getTransmission");
}
