AGH-Drone-Engineering/RPi_CM_Drone_Board/(commit log)

2026-01-29 BOM update
    [CM5IO_BOM.xlsx]
2026-02-11 update BOM
    [CM5IO_BOM.xlsx]
2026-04-29 rename directories, update BOM file, cleanup unnecessary files
    [CM5IO-B_Adhesive.gbr, CM5IO-B_Courtyard.gbr, CM5IO-B_Cu.gbr, CM5IO-B_Fab.gbr, CM5IO-B_Mask.gbr, CM5IO-B_Paste.gbr, CM5IO-B_Silkscreen.gbr, CM5IO-Edge_Cuts.gbr]
2026-04-29 board2 image
2026-07-15 rename CMDB files as rev1
    [CM5IO-B_Adhesive.gbr, CM5IO-B_Courtyard.gbr, CM5IO-B_Cu.gbr, CM5IO-B_Fab.gbr, CM5IO-B_Mask.gbr, CM5IO-B_Paste.gbr, CM5IO-B_Silkscreen.gbr, CM5IO-Edge_Cuts.gbr]
2026-07-15 Update page descriptions, add MD describing post fabrication fixes
    [CM5IO.kicad_sch, CM5_GPIO.kicad_sch, CM5_HighSpeed.kicad_sch, psu.kicad_sch]
2026-07-15 remove unnecessary files, update BOM
    [CM5IO-B_Adhesive.gbr, CM5IO-B_Courtyard.gbr, CM5IO-B_Cu.gbr, CM5IO-B_Fab.gbr, CM5IO-B_Mask.gbr, CM5IO-B_Paste.gbr, CM5IO-B_Silkscreen.gbr, CM5IO-Edge_Cuts.gbr]
2026-07-15 reorganize catalogs
    [CM5IO.kicad_pcb, CM5IO.kicad_sch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]
2026-07-24 Finish loracom (without CRC), add UART protocol description
2026-07-24 Add proper error handling, update docs
    [BasicUart.cpp, BasicUart.h, LoRaCom.cpp, LoRaCom.h, main.cpp]
2026-07-24 Enhance esptesttool - it can now simulate bad UART connection
2026-07-27 fix default device, fix buffer segmentation issue
    [LoRaCom.cpp, LoRaCom.h, main.cpp]
2026-07-27 Add jumper handling and fix use-after-free
    [UartRfBridge.cpp, UartRfBridge.h, main.cpp]
2026-07-31 Add install scripts for utils, camera and hardware wersion. Add hostname setter in bootstrap, add better error handling for loracom and thread-safety. Add commit hash to loracom helpmsg.
    [DeviceLock.cpp, DeviceLock.h, main.cpp]
2026-07-31 fix invalid UART pin assignment
    [main.cpp]
2026-07-31 Fix install script and loracom bugs found in review
    - Restore the executable bit on system-setup.sh and the install-*.sh
    scripts, without which sudo ./system-setup.sh fails with rc=126.
    - Order cmdb-bootstrap.service against dev-ttyAMA3.device instead of
    dev-serial0.device, which is a different UART (ttyAMA10 on a CM5).
    - Build loracom as the invoking user, so root-owned objects in obj/ and
    bin/ no longer break every later non-root make.
    - Symlink /usr/local/bin/loracom, so it resolves from systemd services,
    cron, ssh commands and CMDB_POST_INIT_CMD, none of which read
    /etc/profile.d.
    - Scale the DeviceLock wait to 3*(retries+1), so a waiting instance can
    no longer give up with -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
    [ArgParser.cpp, LoRaCom.cpp, LoRaCom.h, main.cpp]
2026-07-31 add camera support to install scripts
2026-08-01 Restart avahi and add MAC-based fallback hostname to cmdb-bootstrap
    avahi-daemon caches the hostname at its own startup and never picks up
    later changes, so mDNS (*.local) kept announcing the old name after
    set_hostname() ran. Restart it (try-restart, so boards without avahi
    stay untouched) whenever the hostname actually changes.
    Also, if the ESP can't be reached or doesn't hand back a usable
    CMDB_ID, fall back to <prefix>-fallback-<mac> instead of leaving the
    board on whatever hostname the image shipped with.
2026-08-01 add static hostname in case the bootstrap service completely fails
2026-08-05 CMDB-Adv PCB WIP
    [CM5.kicad_sch, CM5_GPIO.kicad_sch, CM5_HighSpeed.kicad_sch, CMDB_Adv.kicad_pcb, CMDB_Adv.kicad_sch, Connectors.kicad_sch, PCIe-M2.kicad_sch, PinSel.kicad_sch]
2026-08-05 Fail-safe killswitch arming in node
    The kill path could leave the aircraft powered with no way to stop it:
    - setup() raised both killswitch gates before checking the address jumpers
    and before begin(), so either failure halted with FC powered and the radio
    dead. startWorkerTask()'s return value was ignored, giving a third such
    path. FC power is now granted only after the kill path is proven up, and
    every failure routes through bootAbort(), which disarms and releases the
    PSU latch so a failed boot looks like a board that will not turn on.
    - KILLSWITCH_PSU_CTL is claimed first, before Serial.begin(), since until it
    is high the board runs on the finger holding SW3.
    - The KILL callb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
    [main.cpp]
2026-08-07 CMDB_Adv WIP
    [CM5.kicad_sch, CMDB_Adv.kicad_pcb, CMDB_Adv.kicad_sch, Connectors.kicad_sch, PCIe-M2.kicad_sch, PlCtrl.kicad_sch, ethconn.kicad_sch, ethernet.kicad_sch]
2026-08-09 Add usb power override to install-cmdb-base.sh
2026-08-18 WIP CMDB-Adv
    [CM5.kicad_sch, CMDB_Adv.kicad_pcb, CMDB_Adv.kicad_sch, Connectors.kicad_sch, PCIe-M2.kicad_sch, PlCtrl.kicad_sch, busmerge1.kicad_sch, busmerge2.kicad_sch]
